PCB-schema/uScope/view2.jpeg

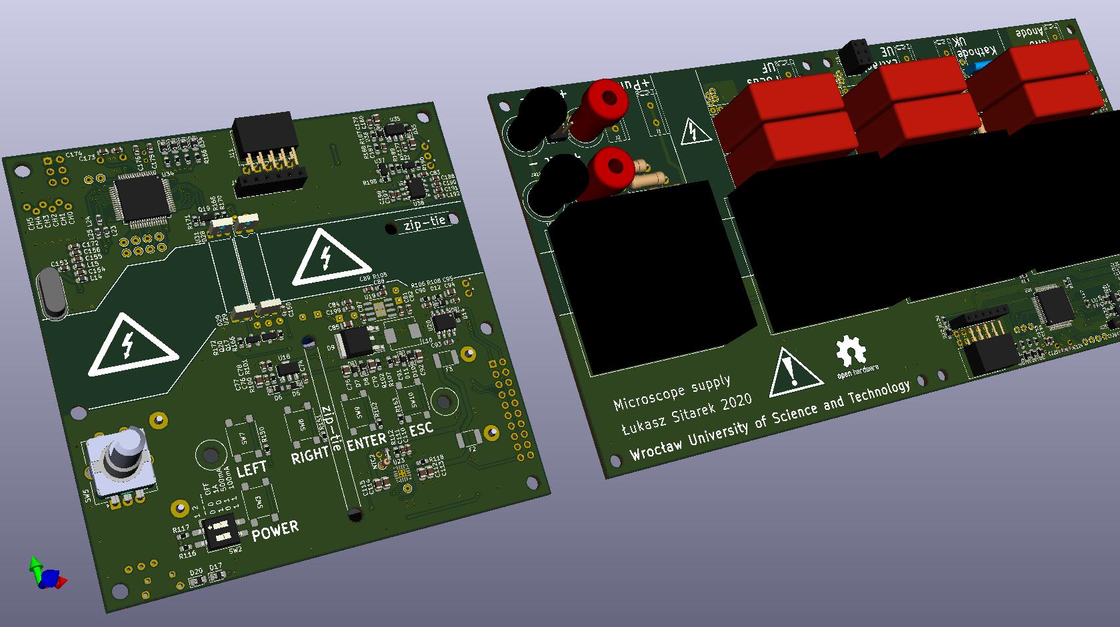
view2.jpeg
