PCB-schema/uScope/view1.jpeg

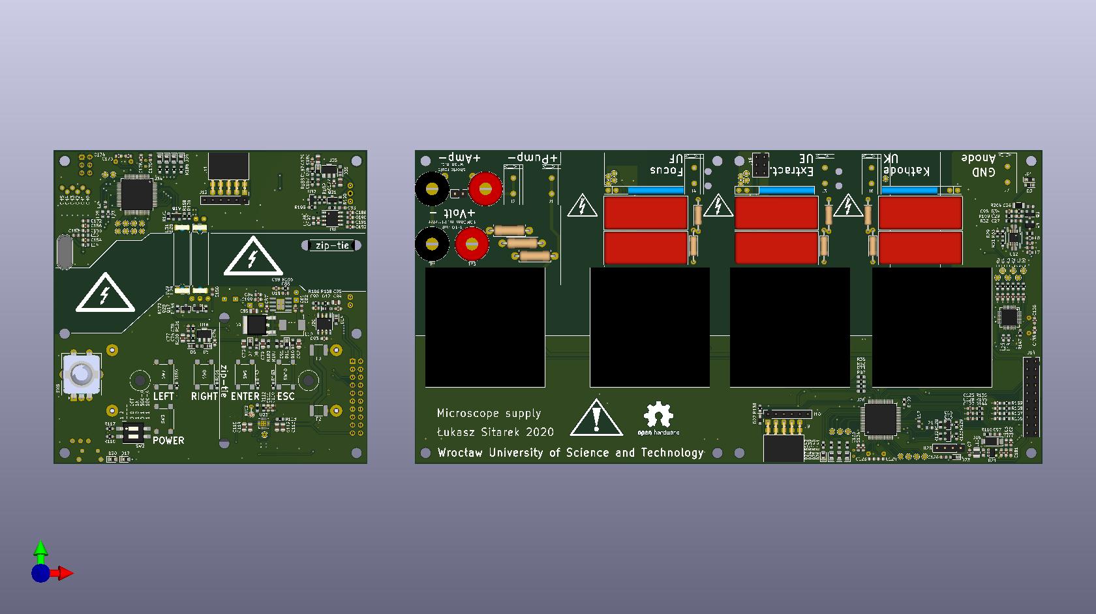
view1.jpeg
