PCB-schema/uScope/README.md

# uScope
Electron microscope
Project created with KiCAD v 5.0.2-bee76a0~70~ubuntu18.04.1, release build
