PCB-schema/uScope/view3.jpeg

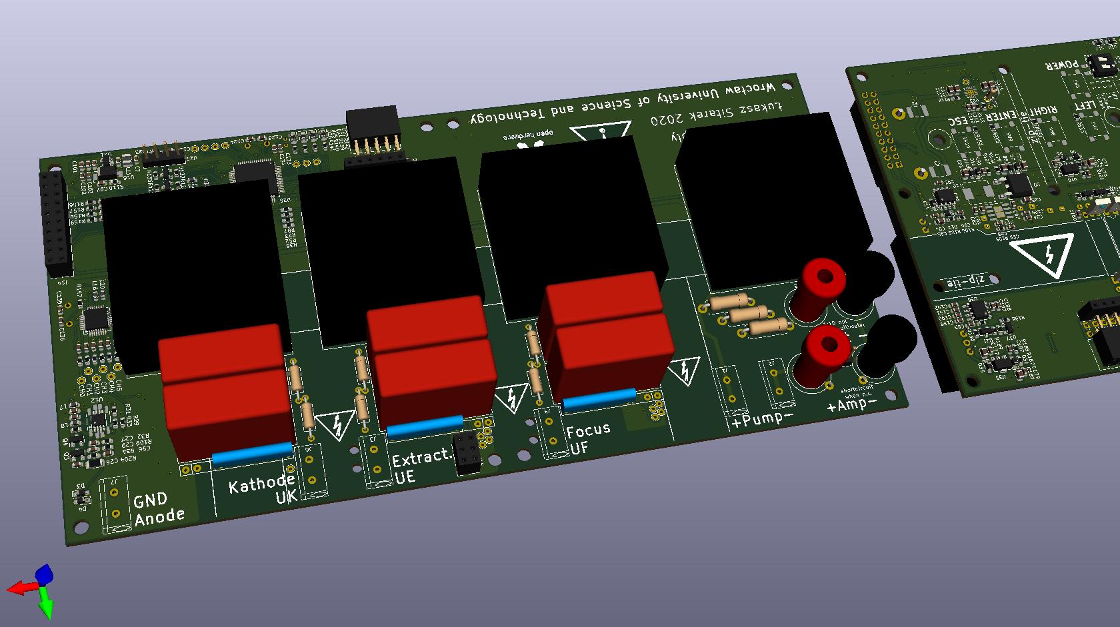
view3.jpeg
