PCB-schema/uScope/view4.jpeg

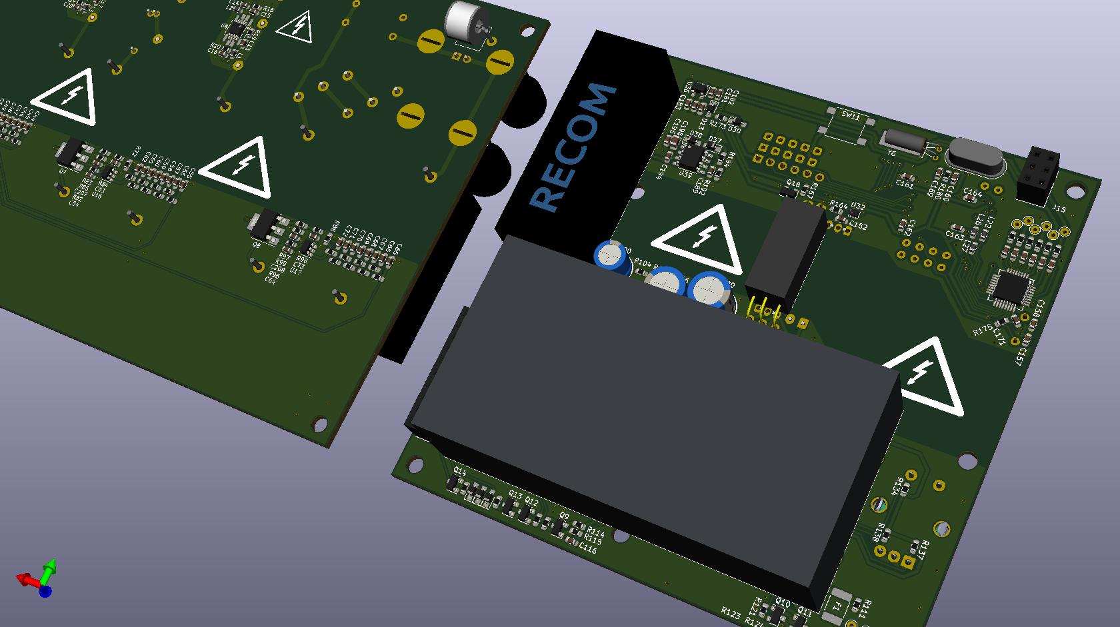
view4.jpeg
