PCB-schema/uScope/view5.jpeg

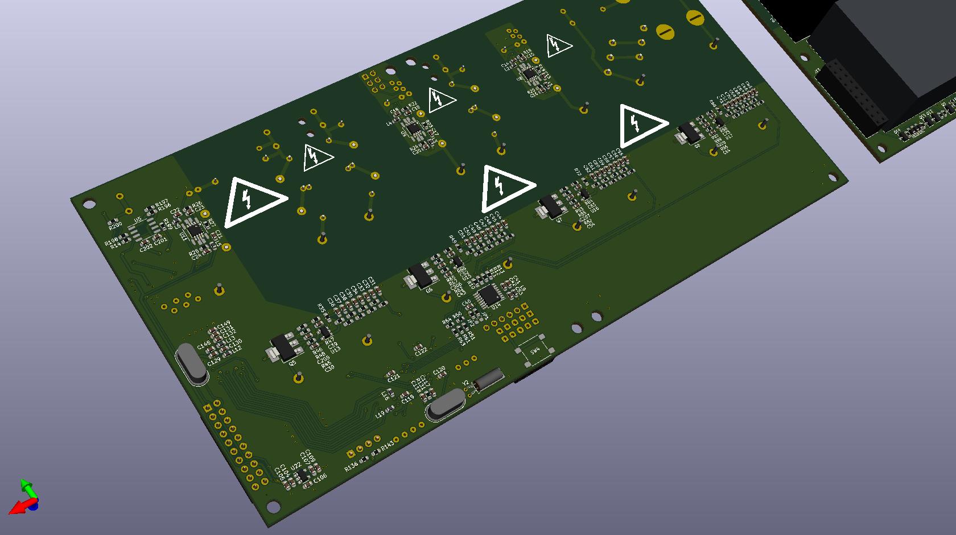
view5.jpeg
