PCB-schema/uScope/uScope.kicad_pcb

## KiCad design uScope.kicad_pcb (2021-03-14)

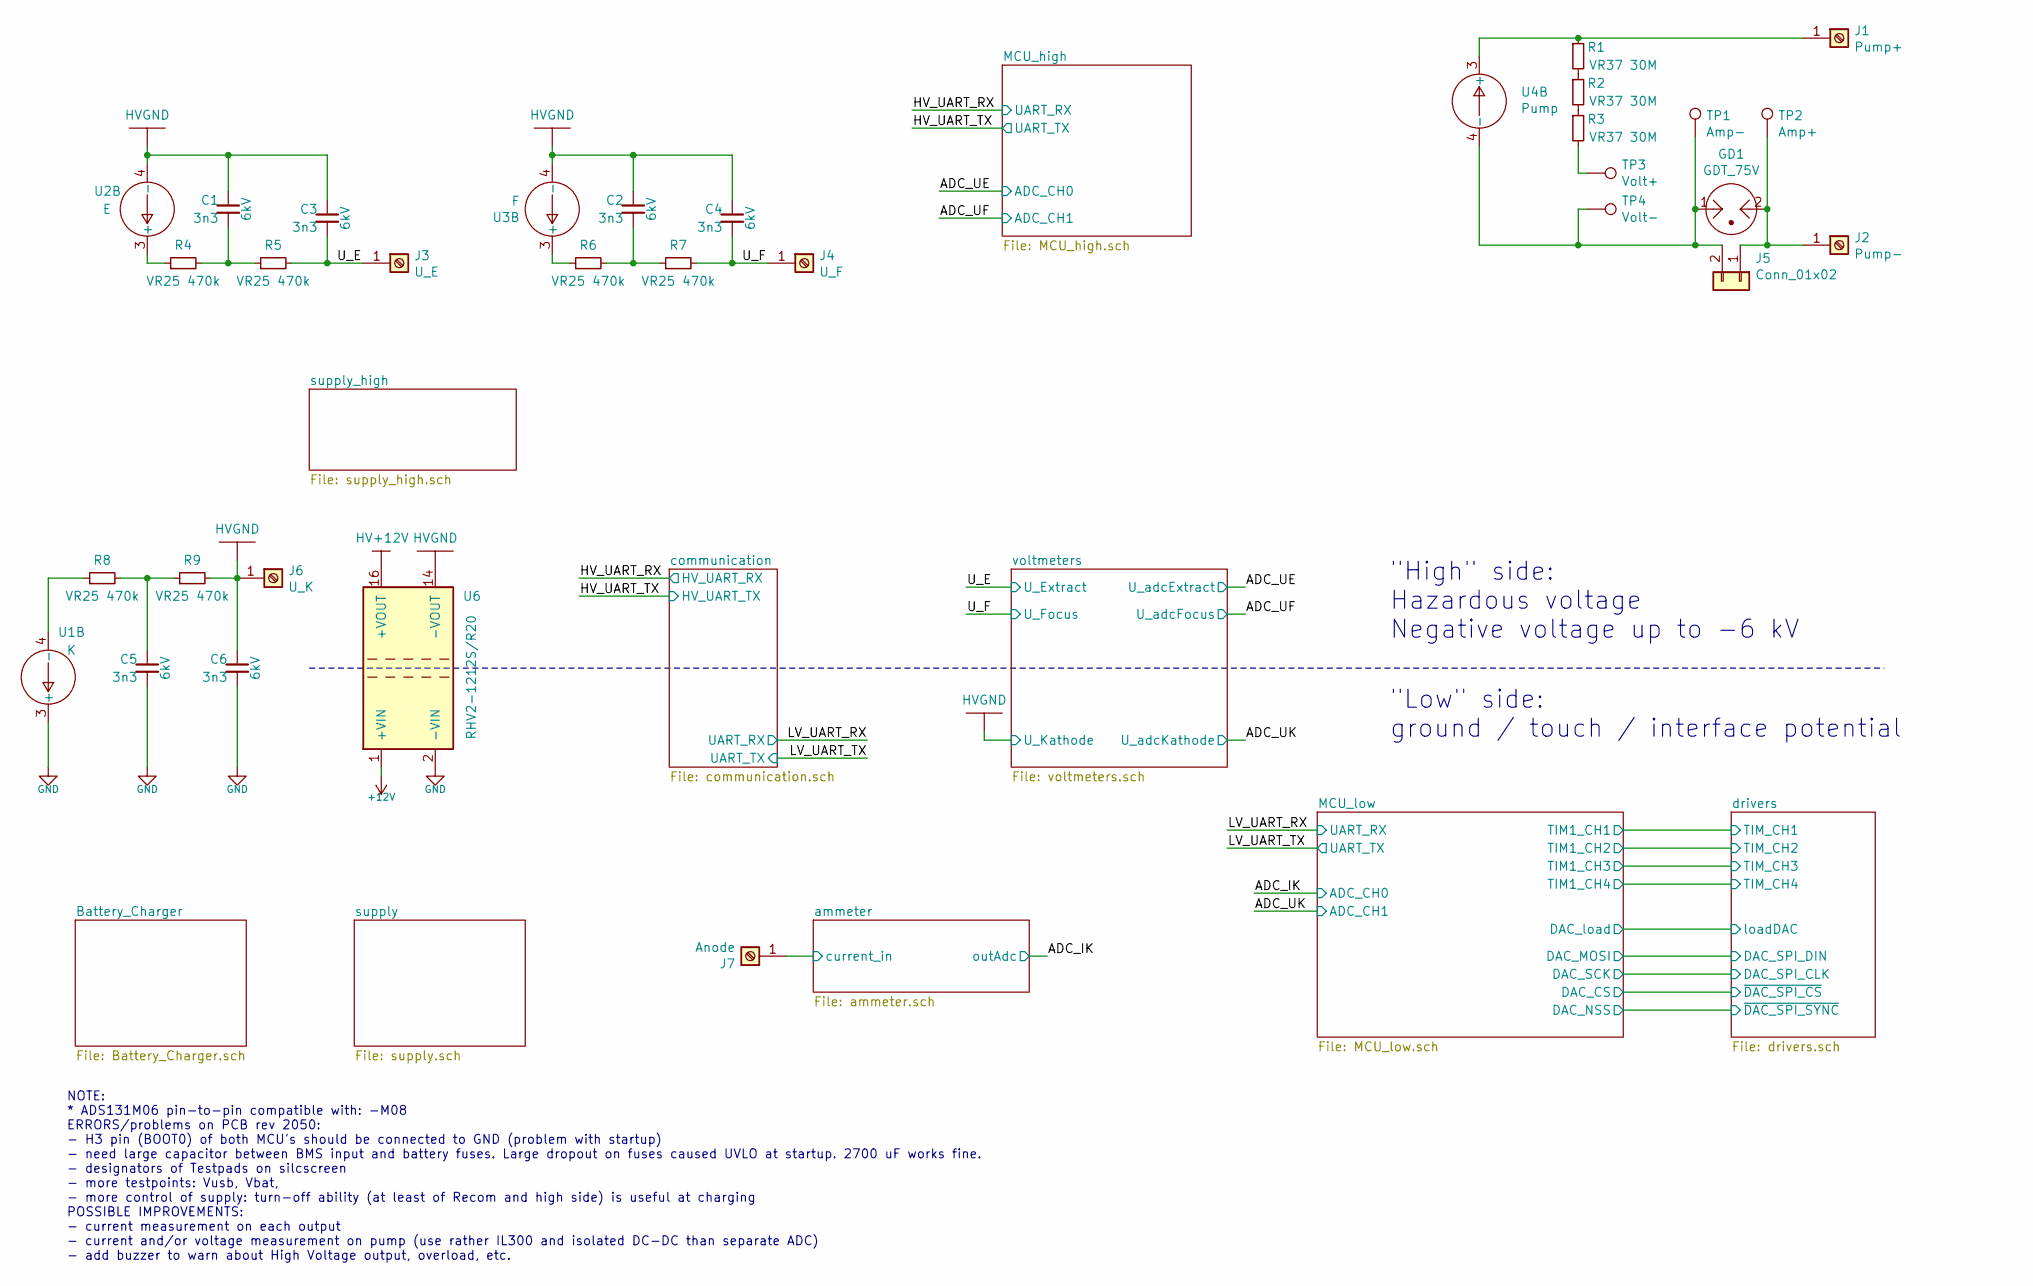
[picture p16: schematic uScope.sch, Schemat główny]

Parts:
C1, C2, C3, C4, C5, C6: 3n3; C_Rect_L26.5mm_W10.5mm_P22.50mm_MKS4; Voltage 6kV
GD1: GDT_75V; Arrester_Axial_L6mm_D6mm_P8.89mm_Horizontal
J1: Pump+; Terminal_Amp_HB0101
J2: Pump-; Terminal_Amp_HB0101
J3: U_E; Terminal_Amp_HB0101
J4: U_F; Terminal_Amp_HB0101
J5: Conn_01x02; PinHeader_1x02_P2.54mm_Vertical
J6: U_K; Terminal_Amp_HB0101
J7: Anode; Terminal_Amp_HB0101
R1, R2, R3: VR37 30M; R_Axial_DIN0411_L9.9mm_D3.6mm_P12.70mm_Horizontal
R4, R5, R6, R7, R8, R9: VR25 470k; R_Axial_DIN0207_L6.3mm_D2.5mm_P10.16mm_Horizontal
TP1: Amp-; Banana4mmSocket_black
TP2: Amp+; Banana4mmSocket_red
TP3: Volt+; Banana4mmSocket_red
TP4: Volt-; Banana4mmSocket_black
U1: K; DCDC_APD_P2_single
U2: E; DCDC_APD_P2_single
U3: F; DCDC_APD_P2_single
U4: Pump; DCDC_APD_P2_single
U6: RHV2-1212S/R20; SIP16_RECOM

Connections:
+12V: U6.1 (+VIN); also elsewhere on the board
/U_E: C3.2, J3.1, R5.2; also elsewhere on the board
/U_F: C4.2, J4.1, R7.2; also elsewhere on the board
/ammeter/current_in: J7.1; also elsewhere on the board
HV+12V: U6.16 (+VOUT); also elsewhere on the board
unnamed: C1.2, R4.2, R5.1
unnamed: C2.2, R6.2, R7.1
unnamed: C5.1, R8.2, R9.1
unnamed: GD1.1, J5.2, TP1.1, TP4.1, U4.4 (-)
unnamed: GD1.2, J2.1, J5.1, TP2.1
unnamed: J1.1, R1.1, U4.3 (+)
unnamed: R1.2, R2.1
unnamed: R2.2, R3.1
unnamed: R3.2, TP3.1
unnamed: R4.1, U2.3 (+)
unnamed: R6.1, U3.3 (+)
unnamed: R8.1, U1.4 (-)

Notes on the sheet:
NOTE: * ADS131M06 pin-to-pin compatible with: -M08 ERRORS/problems on PCB rev 2050: - H3 pin (BOOT0) of both MCU's should be connected to GND (problem with startup) - need large capacitor between BMS input and battery fuses. Large dropout on fuses caused UVLO at startup. 2700 uF works fine. - desig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
"High" side: Hazardous voltage Negative voltage up to -6 kV
"Low" side: ground / touch / interface potential

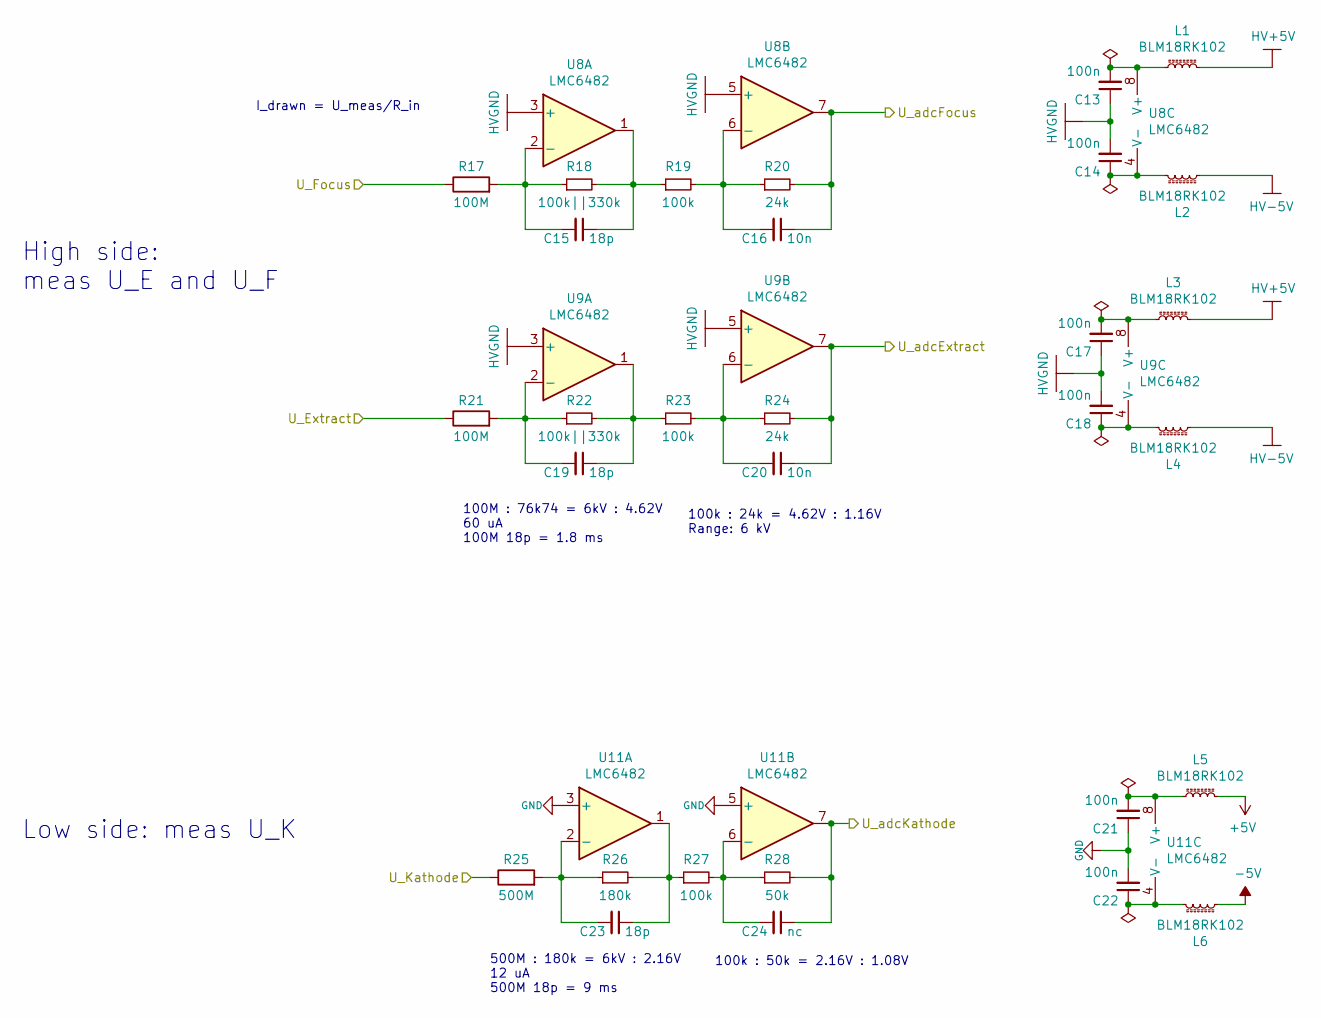
[picture p17: schematic voltmeters.sch, Woltomierze]

Parts:
C13, C14, C17, C18, C21, C22: 100n; C_0603_1608Metric
C15, C19, C23: 18p; C_0603_1608Metric
C16, C20: 10n; C_0603_1608Metric
C24: nc; C_0603_1608Metric
L1, L2, L3, L4, L5, L6: BLM18RK102; L_0603_1608Metric
R17, R21: 100M; MHR0317_0422_0424_0624SA
R18, R22: 100k||330k; R_0603_1608Metric
R19, R23, R27: 100k; R_0603_1608Metric
R20, R24: 24k; R_0603_1608Metric
R25: 500M; MHR0317_0422_0424_0624SA
R26: 180k; R_0603_1608Metric
R28: 50k; R_0603_1608Metric
U8, U9, U11: LMC6482; SO8-MSOP8_3x3mm_P0.65mm

Connections:
+5V: L5.2; also elsewhere on the board
-5V: L6.1; also elsewhere on the board
/ADC_UE: C20.1, R24.2, U9.7; also elsewhere on the board
/ADC_UF: C16.1, R20.2, U8.7; also elsewhere on the board
/ADC_UK: C24.1, R28.2, U11.7; also elsewhere on the board
/U_E: R21.1; also elsewhere on the board
/U_F: R17.1; also elsewhere on the board
HV+5V: L1.2, L3.2; also elsewhere on the board
HV-5V: L2.1, L4.1; also elsewhere on the board
unnamed: C13.2, L1.1, U8.8 (V+)
unnamed: C14.1, L2.2, U8.4 (V-)
unnamed: C15.1, R18.2, R19.1, U8.1
unnamed: C15.2, R17.2, R18.1, U8.2 (-)
unnamed: C16.2, R19.2, R20.1, U8.6 (-)
unnamed: C17.2, L3.1, U9.8 (V+)
unnamed: C18.1, L4.2, U9.4 (V-)
unnamed: C19.1, R22.2, R23.1, U9.1
unnamed: C19.2, R21.2, R22.1, U9.2 (-)
unnamed: C20.2, R23.2, R24.1, U9.6 (-)
unnamed: C21.2, L5.1, U11.8 (V+)
unnamed: C22.1, L6.2, U11.4 (V-)
unnamed: C23.1, R26.2, R27.1, U11.1
unnamed: C23.2, R25.2, R26.1, U11.2 (-)
unnamed: C24.2, R27.2, R28.1, U11.6 (-)

Notes on the sheet:
I_drawn = U_meas/R_in
Low side: meas U_K
High side: meas U_E and U_F
500M : 180k = 6kV : 2.16V 12 uA 500M 18p = 9 ms
100k : 50k = 2.16V : 1.08V
100M : 76k74 = 6kV : 4.62V 60 uA 100M 18p = 1.8 ms
100k : 24k = 4.62V : 1.16V Range: 6 kV

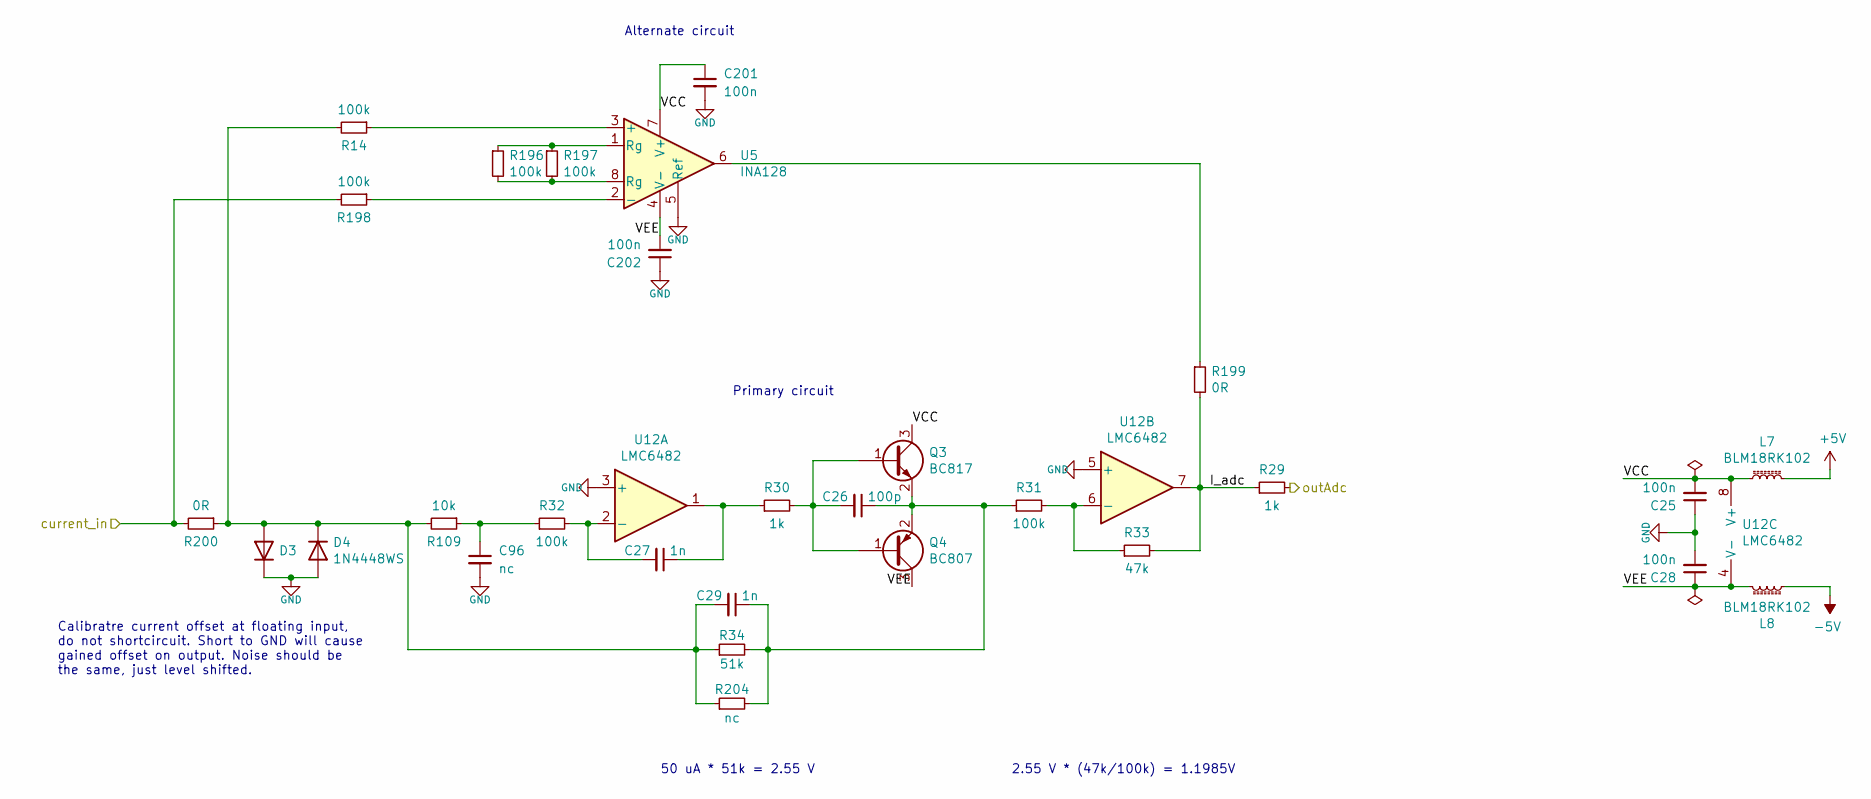
[picture p18: schematic ammeter.sch, Amperomierz]

Parts:
C25, C28, C201, C202: 100n; C_0603_1608Metric
C26: 100p; C_0603_1608Metric
C27: 1n; C_0603_1608Metric
C29: 1n; C_0603_1608Metric_Pad1.05x0.95mm_HandSolder
C96: nc; C_0603_1608Metric
D3, D4: 1N4448WS; D_SOD-323-523_HandSoldering
L7, L8: BLM18RK102; L_0603_1608Metric
Q3: BC817; SOT-23
Q4: BC807; SOT-23
R14, R31, R32, R198: 100k; R_0603_1608Metric
R29, R30: 1k; R_0603_1608Metric
R33: 47k; R_0603_1608Metric
R34: 51k; R_0603_1608Metric_Pad1.05x0.95mm_HandSolder
R109: 10k; R_0603_1608Metric
R196, R197: 100k; R_0603_1608Metric_Pad1.05x0.95mm_HandSolder
R199: 0R; R_0603_1608Metric
R200: 0R; R_0603_1608Metric_Pad1.05x0.95mm_HandSolder
R204: nc; R_1206_3216Metric
U5: INA128; SO-8_3.9x4.9mm_P1.27mm
U12: LMC6482; SO8-MSOP8_3x3mm_P0.65mm

Connections:
+5V: L7.2; also elsewhere on the board
-5V: L8.1; also elsewhere on the board
/ADC_IK: R29.2; also elsewhere on the board
/ammeter/I_adc: R29.1, R33.2, R199.2, U12.7
/ammeter/VCC: C25.2, C201.1, L7.1, Q3.3 (C), U5.7 (V+), U12.8 (V+)
/ammeter/VEE: C28.1, C202.2, L8.2, Q4.3 (C), U5.4 (V-), U12.4 (V-)
/ammeter/current_in: R198.2, R200.2; also elsewhere on the board
unnamed: C26.1, C29.1, Q3.2 (E), Q4.2 (E), R31.1, R34.2, R204.2
unnamed: C26.2, Q3.1 (B), Q4.1 (B), R30.2
unnamed: C27.1, R30.1, U12.1
unnamed: C27.2, R32.2, U12.2 (-)
unnamed: C29.2, D3.2 (A), D4.1 (K), R14.2, R34.1, R109.2, R200.1, R204.1
unnamed: C96.1, R32.1, R109.1
unnamed: R14.1, U5.3 (+)
unnamed: R31.2, R33.1, U12.6 (-)
unnamed: R196.1, R197.1, U5.1 (Rg)
unnamed: R196.2, R197.2, U5.8 (Rg)
unnamed: R198.1, U5.2 (-)
unnamed: R199.1, U5.6

Notes on the sheet:
Primary circuit
Alternate circuit
50 uA * 51k = 2.55 V
2.55 V * (47k/100k) = 1.1985V
Calibratre current offset at floating input, do not shortcircuit. Short to GND will cause gained offset on output. Noise should be the same, just level shifted.

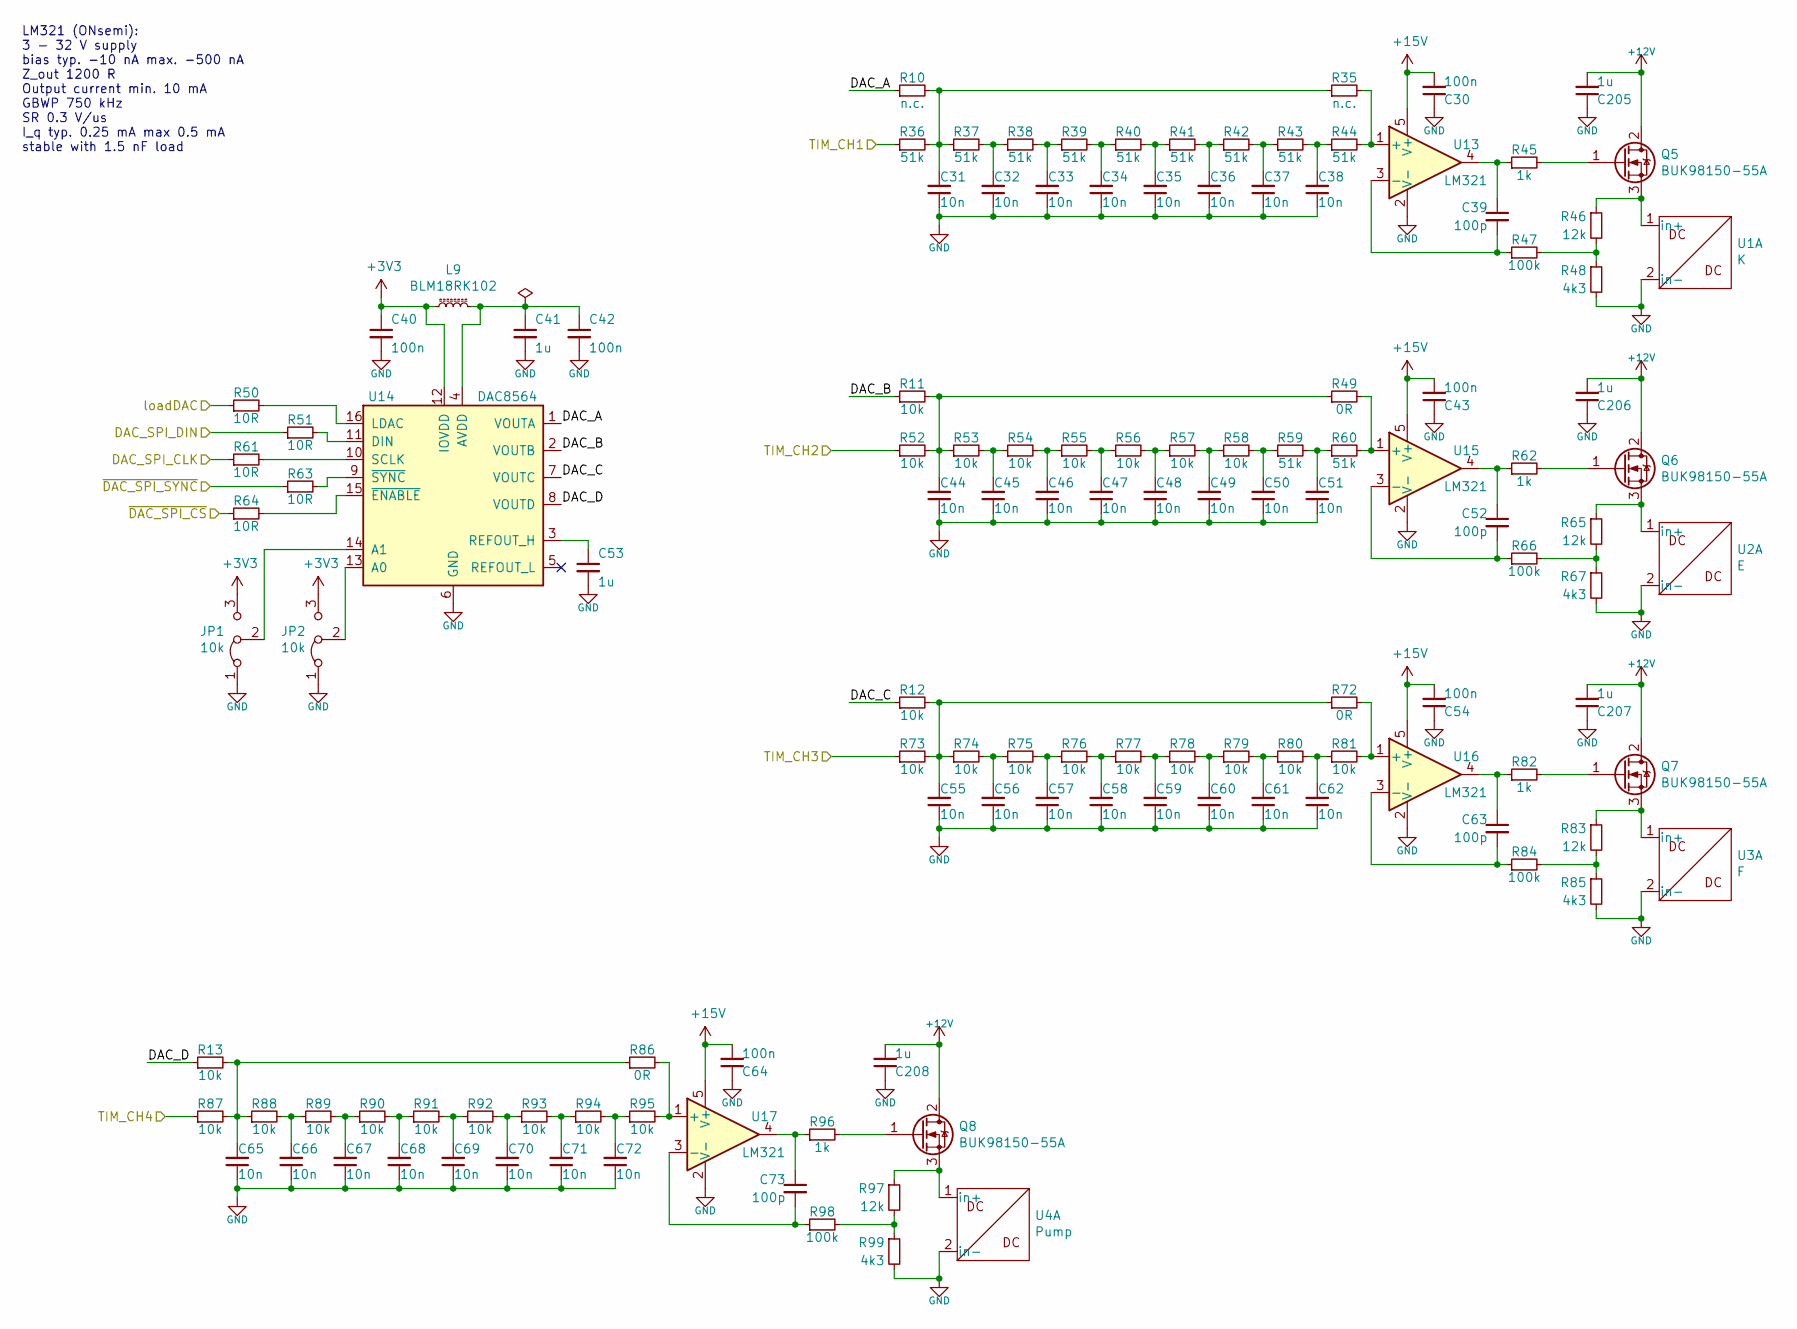
[picture p19: schematic drivers.sch, Sterowniki]

Parts:
C30, C40, C42, C43, C54, C64: 100n; C_0603_1608Metric
C31, C32, C33, C34, C35, C36, C37, C38, C44, C45, C46, C47, C48, C49, C50, C51, C55, C56, C57, C58, C59, C60, C61, C62, C65, C66, C67, C68, C69, C70, C71, C72: 10n; C_0603_1608Metric_Pad1.05x0.95mm_HandSolder
C39, C52, C63, C73: 100p; C_0603_1608Metric
C41, C53, C205, C206, C207, C208: 1u; C_0603_1608Metric
JP1, JP2: 10k; Jumper_3P_0603_1608Metric_open
L9: BLM18RK102; L_0603_1608Metric
Q5, Q6, Q7, Q8: BUK98150-55A; SOT-223-3_TabPin2
R10, R35: n.c.; R_0603_1608Metric_Pad1.05x0.95mm_HandSolder
R11, R12, R13, R52, R53, R54, R55, R56, R57, R58, R73, R74, R75, R76, R77, R78, R79, R80, R81, R87, R88, R89, R90, R91, R92, R93, R94, R95: 10k; R_0603_1608Metric_Pad1.05x0.95mm_HandSolder
R36, R37, R38, R39, R40, R41, R42, R43, R44, R59, R60: 51k; R_0603_1608Metric_Pad1.05x0.95mm_HandSolder
R45, R62, R82, R96: 1k; R_0603_1608Metric
R46, R65, R83, R97: 12k; R_0603_1608Metric_Pad1.05x0.95mm_HandSolder
R47, R66, R84, R98: 100k; R_0603_1608Metric
R48, R67, R85, R99: 4k3; R_0603_1608Metric_Pad1.05x0.95mm_HandSolder
R49, R72, R86: 0R; R_0603_1608Metric_Pad1.05x0.95mm_HandSolder
R50, R51, R61, R63, R64: 10R; R_0603_1608Metric
U1: K; DCDC_APD_P2_single
U2: E; DCDC_APD_P2_single
U3: F; DCDC_APD_P2_single
U4: Pump; DCDC_APD_P2_single
U13, U15, U16, U17: LM321; SOT-23-5
U14: DAC8564; TSSOP-16_4.4x5mm_P0.65mm

Connections:
+3V3: C40.1, JP1.3 (B), JP2.3 (B), L9.1, U14.12 (IOVDD); also elsewhere on the board
+12V: C205.2, C206.2, C207.2, C208.2, Q5.2 (D), Q6.2 (D), Q7.2 (D), Q8.2 (D); also elsewhere on the board
+15V: C30.2, C43.2, C54.2, C64.2, U13.5 (V+), U15.5 (V+), U16.5 (V+), U17.5 (V+); also elsewhere on the board
/MCU_low/DAC_CS: R64.1; also elsewhere on the board
/MCU_low/DAC_MOSI: R51.1; also elsewhere on the board
/MCU_low/DAC_NSS: R63.1; also elsewhere on the board
/MCU_low/DAC_SCK: R61.1; also elsewhere on the board
/MCU_low/DAC_load: R50.1; also elsewhere on the board
/MCU_low/TIM1_CH1: R36.1; also elsewhere on the board
/MCU_low/TIM1_CH2: R52.1; also elsewhere on the board
/MCU_low/TIM1_CH3: R73.1; also elsewhere on the board
/MCU_low/TIM1_CH4: R87.1; also elsewhere on the board
/drivers/DAC_A: R10.1, U14.1 (VOUTA)
/drivers/DAC_B: R11.1, U14.2 (VOUTB)
/drivers/DAC_C: R12.1, U14.7 (VOUTC)
/drivers/DAC_D: R13.1, U14.8 (VOUTD)
unnamed: C31.2, R10.2, R35.1, R36.2, R37.1
unnamed: C32.2, R37.2, R38.1
unnamed: C33.2, R38.2, R39.1
unnamed: C34.2, R39.2, R40.1
unnamed: C35.2, R40.2, R41.1
unnamed: C36.2, R41.2, R42.1
unnamed: C37.2, R42.2, R43.1
unnamed: C38.2, R43.2, R44.1
unnamed: C39.1, R45.1, U13.4
unnamed: C39.2, R47.1, U13.3 (-)
unnamed: C41.1, C42.1, L9.2, U14.4 (AVDD)
unnamed: C44.2, R11.2, R49.1, R52.2, R53.1
unnamed: C45.2, R53.2, R54.1
unnamed: C46.2, R54.2, R55.1
unnamed: C47.2, R55.2, R56.1
unnamed: C48.2, R56.2, R57.1
unnamed: C49.2, R57.2, R58.1
unnamed: C50.2, R58.2, R59.1
unnamed: C51.2, R59.2, R60.1
unnamed: C52.1, R62.1, U15.4
unnamed: C52.2, R66.1, U15.3 (-)
unnamed: C53.1, U14.3 (REFOUT_H)
unnamed: C55.2, R12.2, R72.1, R73.2, R74.1
unnamed: C56.2, R74.2, R75.1
unnamed: C57.2, R75.2, R76.1
unnamed: C58.2, R76.2, R77.1
unnamed: C59.2, R77.2, R78.1
unnamed: C60.2, R78.2, R79.1
unnamed: C61.2, R79.2, R80.1
unnamed: C62.2, R80.2, R81.1
unnamed: C63.1, R82.1, U16.4
unnamed: C63.2, R84.1, U16.3 (-)
unnamed: C65.2, R13.2, R86.1, R87.2, R88.1
unnamed: C66.2, R88.2, R89.1
unnamed: C67.2, R89.2, R90.1
unnamed: C68.2, R90.2, R91.1
unnamed: C69.2, R91.2, R92.1
unnamed: C70.2, R92.2, R93.1
unnamed: C71.2, R93.2, R94.1
unnamed: C72.2, R94.2, R95.1
unnamed: C73.1, R96.1, U17.4
unnamed: C73.2, R98.1, U17.3 (-)
unnamed: JP1.2 (C), U14.14 (A1)
unnamed: JP2.2 (C), U14.13 (A0)
unnamed: Q5.1 (G), R45.2
unnamed: Q5.3 (S), R46.1, U1.1 (in+)
unnamed: Q6.1 (G), R62.2
unnamed: Q6.3 (S), R65.1, U2.1 (in+)
unnamed: Q7.1 (G), R82.2
unnamed: Q7.3 (S), R83.1, U3.1 (in+)
unnamed: Q8.1 (G), R96.2
unnamed: Q8.3 (S), R97.1, U4.1 (in+)
unnamed: R35.2, R44.2, U13.1 (+)
unnamed: R46.2, R47.2, R48.1
unnamed: R49.2, R60.2, U15.1 (+)
unnamed: R50.2, U14.16 (LDAC)
unnamed: R51.2, U14.11 (DIN)
unnamed: R61.2, U14.10 (SCLK)
unnamed: R63.2, U14.9 (~SYNC)
unnamed: R64.2, U14.15 (~ENABLE)
unnamed: R65.2, R66.2, R67.1
unnamed: R72.2, R81.2, U16.1 (+)
unnamed: R83.2, R84.2, R85.1
unnamed: R86.2, R95.2, U17.1 (+)
unnamed: R97.2, R98.2, R99.1

Notes on the sheet:
LM321 (ONsemi): 3 - 32 V supply bias typ. -10 nA max. -500 nA Z_out 1200 R Output current min. 10 mA GBWP 750 kHz SR 0.3 V/us I_q typ. 0.25 mA max 0.5 mA stable with 1.5 nF load

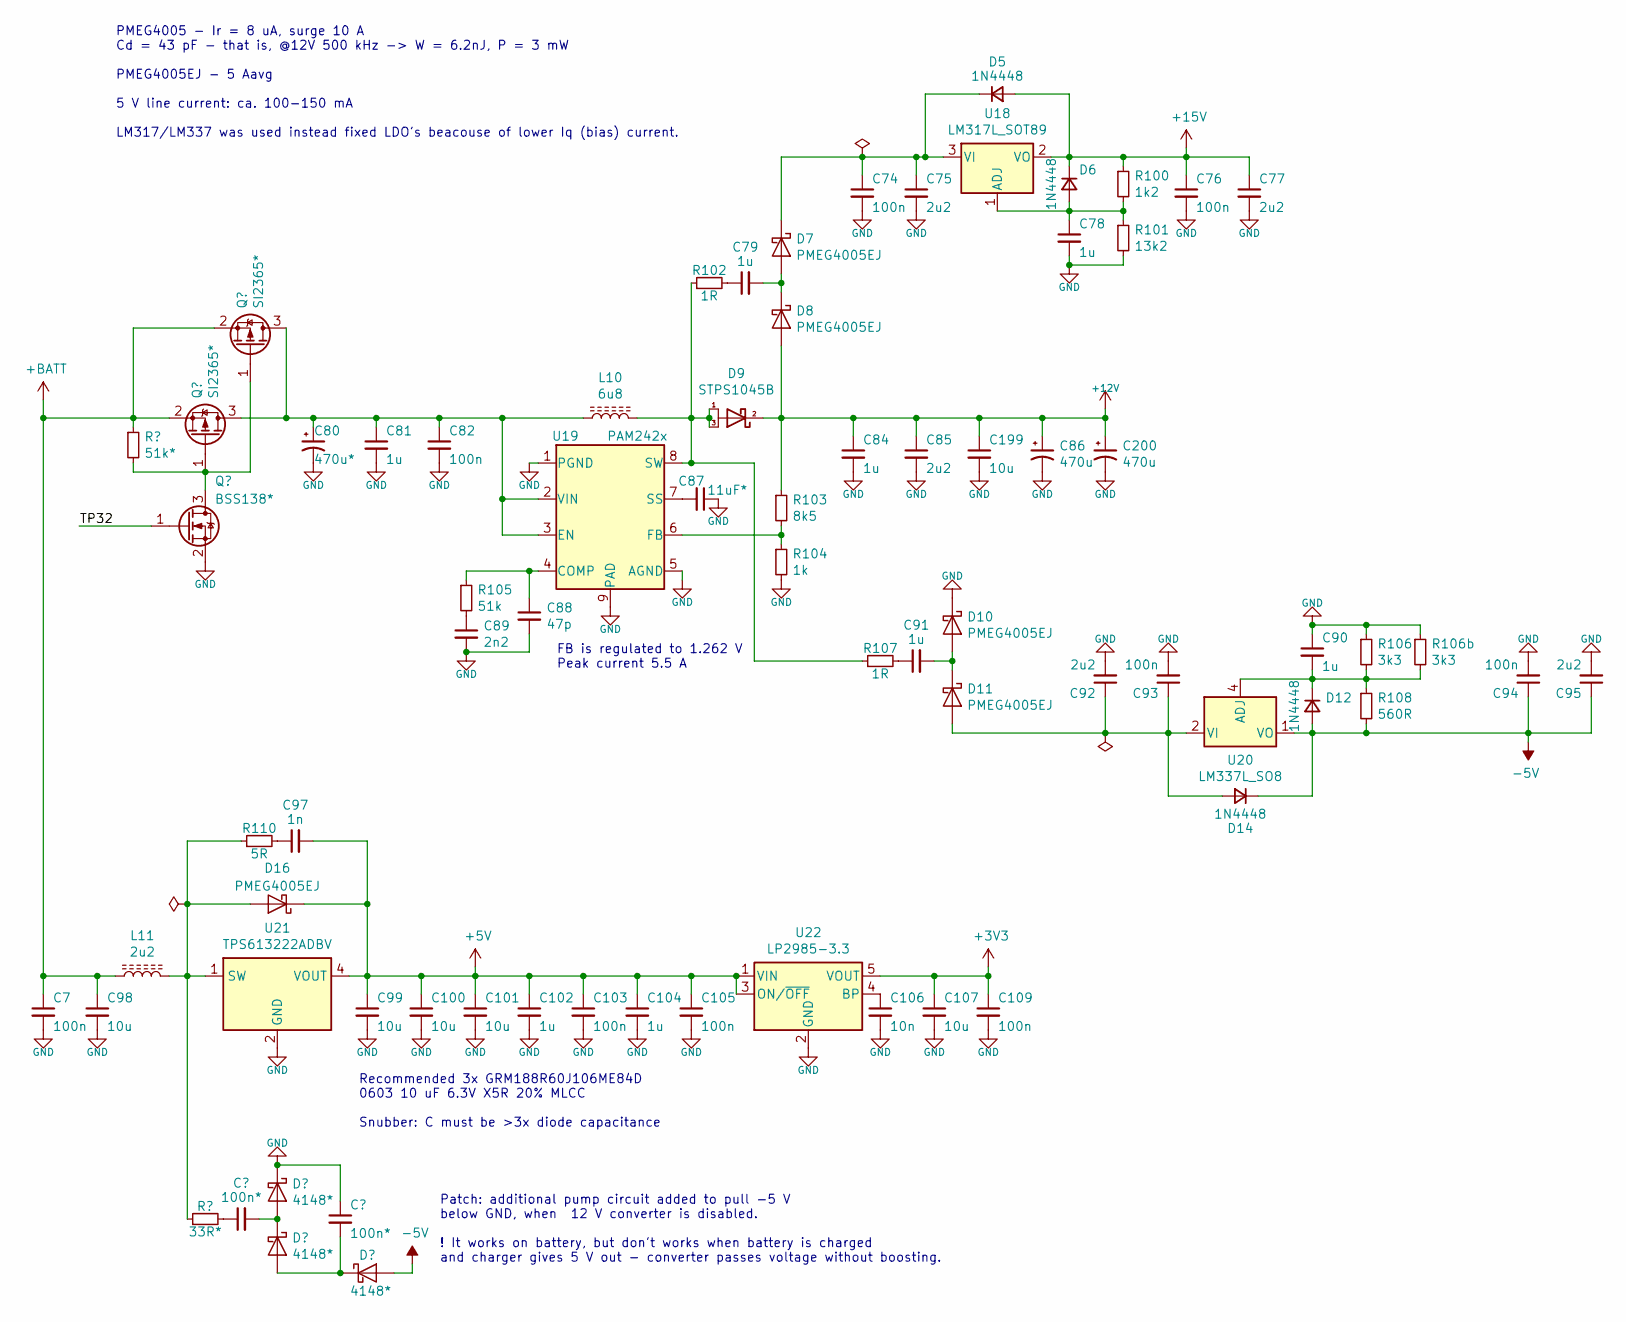
[picture p20: schematic supply.sch, Zasilanie - anoda]

Parts:
C7, C74, C76, C82, C93, C94, C103, C105, C109: 100n; C_0603_1608Metric
C75, C77, C85, C95: 2u2; C_0805_2012Metric
C78, C81, C84, C90, C91, C102, C104: 1u; C_0603_1608Metric
C79: 1u; C_0805_2012Metric_Pad1.15x1.40mm_HandSolder
C80: 470u*; CP_Radial_D6.3mm_P2.50mm
C86, C200: 470u; CP_Radial_D8.0mm_P3.50mm
C87: 11uF*; C_0603_1608Metric
C88: 47p; C_0603_1608Metric
C89: 2n2; C_0603_1608Metric
C92: 2u2; C_0805_2012Metric_Pad1.15x1.40mm_HandSolder
C97: 1n; C_0603_1608Metric
C98, C99, C100, C101, C107, C199: 10u; C_0603_1608Metric_Pad1.05x0.95mm_HandSolder
C106: 10n; C_0603_1608Metric
D5, D6, D12, D14: 1N4448; D_SOD-323-523_HandSoldering
D7, D8, D10, D11: PMEG4005EJ; D_SOD-323-523_HandSoldering
D9: STPS1045B; TO-252-2
D16: PMEG4005EJ; D_SOD-323-523-SMA_Universal_Handsoldering
L10: 6u8; L_Abracon_ASPI-0630LR
L11: 2u2; L_1008_2520Metric
R100: 1k2; R_0603_1608Metric
R101: 13k2; R_0603_1608Metric
R102, R107: 1R; R_0603_1608Metric_Pad1.05x0.95mm_HandSolder
R103: 8k5; R_0603_1608Metric
R104: 1k; R_0603_1608Metric
R105: 51k; R_0603_1608Metric
R106: 3k3; R_0603_1608Metric
R106b: 3k3
R108: 560R; R_0603_1608Metric
R110: 5R; R_0603_1608Metric_Pad1.05x0.95mm_HandSolder
U18: LM317L_SOT89; SOT-89-3
U19: PAM242x; SOIC-8-1EP_3.9x4.9mm_P1.27mm_EP2.41x3.3mm_ThermalVias
U20: LM337L_SO8; SOIC-8_3.9x4.9mm_P1.27mm
U21: TPS613222ADBV; SOT-23-5
U22: LP2985-3.3; SOT-23-5

Connections:
+3V3: C107.1, C109.1, U22.5 (VOUT); also elsewhere on the board
+5V: C97.2, C99.1, C100.1, C101.1, C102.1, C103.1, C104.1, C105.1, D16.1 (K), U21.4 (VOUT), U22.1 (VIN), U22.3 (ON/~OFF~); also elsewhere on the board
+12V: C84.1, C85.1, C86.1, C199.1, C200.1, D8.2 (A), D9.2 (K), R103.1; also elsewhere on the board
+15V: C76.1, C77.1, D5.2 (A), D6.1 (K), R100.1, U18.2 (VO); also elsewhere on the board
-5V: C94.1, C95.1, D12.2 (A), D14.1 (K), R108.2, U20.1 (VO); also elsewhere on the board
unnamed: C74.1, C75.1, D5.1 (K), D7.1 (K), U18.3 (VI)
unnamed: C78.1, D6.2 (A), R100.2, R101.1, U18.1 (ADJ)
unnamed: C79.1, R102.2
unnamed: C79.2, D7.2 (A), D8.1 (K)
unnamed: C87.2, U19.7 (SS)
unnamed: C88.1, R105.1, U19.4 (COMP)
unnamed: C89.1, R105.2
unnamed: C90.2, D12.1 (K), R106.2, R106b.2, R108.1, U20.4 (ADJ)
unnamed: C91.1, R107.2
unnamed: C91.2, D10.2 (A), D11.1 (K)
unnamed: C92.1, C93.1, D11.2 (A), D14.2 (A), U20.2 (VI), U20.3 (VI), U20.6 (VI), U20.7 (VI)
unnamed: C97.1, R110.2
unnamed: C106.1, U22.4 (BP)
unnamed: D9.1 (A), D9.3 (A), L10.2, R102.1, R107.1, U19.8 (SW)
unnamed: D16.2 (A), L11.2, R110.1, U21.1 (SW)
unnamed: R103.2, R104.1, U19.6 (FB)

Notes on the sheet:
FB is regulated to 1.262 V Peak current 5.5 A
PMEG4005 - Ir = 8 uA, surge 10 A Cd = 43 pF - that is, @12V 500 kHz -> W = 6.2nJ, P = 3 mW PMEG4005EJ - 5 Aavg 5 V line current: ca. 100-150 mA LM317/LM337 was used instead fixed LDO's beacouse of lower Iq (bias) current.
Recommended 3x GRM188R60J106ME84D 0603 10 uF 6.3V X5R 20% MLCC Snubber: C must be >3x diode capacitance
Patch: additional pump circuit added to pull -5 V below GND, when 12 V converter is disabled. ! It works on battery, but don't works when battery is charged and charger gives 5 V out - converter passes voltage without boosting.

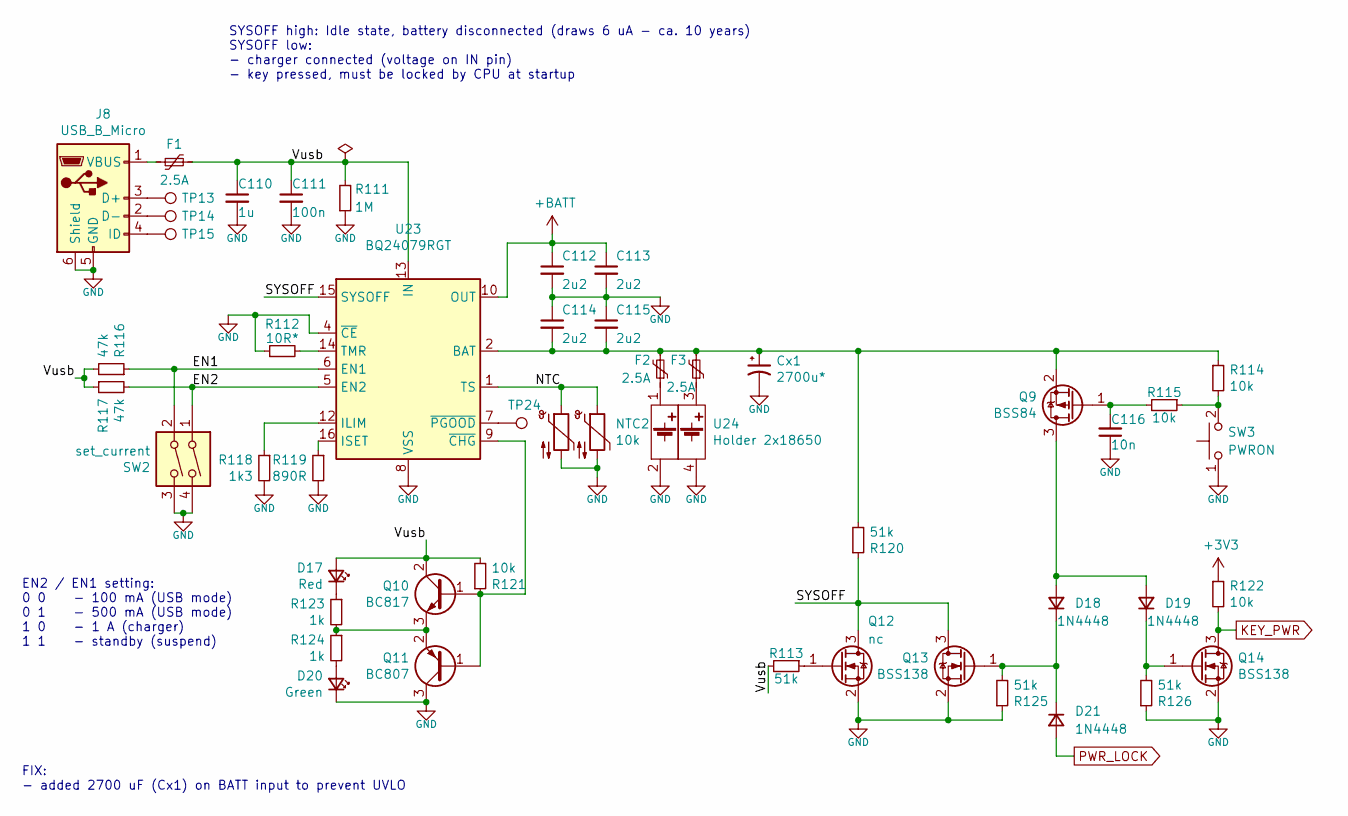
[picture p21: schematic Battery_Charger.sch, Zasilanie - bateria]

Parts:
C110: 1u; C_0603_1608Metric
C111: 100n; C_0603_1608Metric
C112, C113, C114, C115: 2u2; C_0805_2012Metric
C116: 10n; C_0603_1608Metric
Cx1: 2700u*
D17: Red; D_0805_2012Metric_Pad1.15x1.40mm_HandSolder
D18, D19, D21: 1N4448; D_SOD-323-523_HandSoldering
D20: Green; D_0805_2012Metric_Pad1.15x1.40mm_HandSolder
F1, F2, F3: 2.5A; Fuse_1812_4532Metric_Pad1.30x3.40mm_HandSolder
J8: USB_B_Micro; USB_Micro-B_Amphenol_10118194_Horizontal
NTC1: 10k; R_1206_3216Metric_Pad1.42x1.75mm_HandSolder
NTC2: 10k; R_Axial_DIN0204_L3.6mm_D1.6mm_P2.54mm_Vertical
Q9: BSS84; SOT-23
Q10: BC817; SOT-23
Q11: BC807; SOT-23
Q12: nc; SOT-23
Q13, Q14: BSS138; SOT-23
R111: 1M; R_0603_1608Metric
R112: 10R*; R_0603_1608Metric
R113, R120, R125, R126: 51k; R_0603_1608Metric
R114, R115, R121, R122: 10k; R_0603_1608Metric
R116, R117: 47k; R_0603_1608Metric
R118: 1k3; R_0603_1608Metric_Pad1.05x0.95mm_HandSolder
R119: 890R; R_0603_1608Metric_Pad1.05x0.95mm_HandSolder
R123, R124: 1k; R_0603_1608Metric
SW2: set_current; SW_DIP_SPSTx02_Slide_6.7x6.64mm_W8.61mm_P2.54mm_LowProfile
SW3: PWRON; SW_Push_1P1T_NO_6x6mm_H9.5mm
TP13, TP14, TP15, TP24: TestPoint; TestPoint_THTPad_D1.5mm_Drill0.7mm
U23: BQ24079RGT; VQFN-16-1EP_3x3mm_P0.5mm_EP1.6x1.6mm
U24: Holder 2x18650; BatteryHolder_Eagle-12BHC186P

Connections:
+3V3: R122.1; also elsewhere on the board
/Battery_Charger/EN1: R116.1, SW2.2, U23.6 (EN1)
/Battery_Charger/EN2: R117.2, SW2.1, U23.5 (EN2)
/Battery_Charger/NTC: NTC1.1, NTC2.1, U23.1 (TS)
/Battery_Charger/SYSOFF: Q12.3 (D), Q13.3 (D), R120.1, U23.15 (SYSOFF)
/Battery_Charger/Vusb: C110.1, C111.1, D17.2 (A), F1.2, Q10.2 (C), R111.2, R113.2, R116.2, R117.1, R121.2, U23.13 (IN)
KEY_PWR: Q14.3 (D), R122.2; also elsewhere on the board
unnamed: C114.2, C115.2, Cx1.1, F2.2, F3.2, Q9.2 (S), R114.1, R120.2, U23.2 (BAT), U23.3 (BAT)
unnamed: C116.2, Q9.1 (G), R115.2
unnamed: D17.1 (K), R123.1
unnamed: D18.1 (K), D21.1 (K), Q13.1 (G), R125.2
unnamed: D18.2 (A), D19.2 (A), Q9.3 (D)
unnamed: D19.1 (K), Q14.1 (G), R126.2
unnamed: D20.2 (A), R124.2
unnamed: F1.1, J8.1 (VBUS)
unnamed: F2.1, U24.1 (1+)
unnamed: F3.1, U24.3 (2+)
unnamed: J8.2 (D-), TP14.1
unnamed: J8.3 (D+), TP13.1
unnamed: J8.4 (ID), TP15.1
unnamed: Q10.1 (B), Q11.1 (B), R121.1, U23.9 (~CHG)
unnamed: Q10.3 (E), Q11.2 (E), R123.2, R124.1
unnamed: Q12.1 (G), R113.1
unnamed: R112.2, U23.14 (TMR)
unnamed: R114.2, R115.1, SW3.2
unnamed: R118.1, U23.12 (ILIM)
unnamed: R119.1, U23.16 (ISET)
unnamed: TP24.1, U23.7 (~PGOOD)
PWR_LOCK: D21.2 (A); also elsewhere on the board

Notes on the sheet:
SYSOFF high: Idle state, battery disconnected (draws 6 uA - ca. 10 years) SYSOFF low: - charger connected (voltage on IN pin) - key pressed, must be locked by CPU at startup
EN2 / EN1 setting: 0 0 - 100 mA (USB mode) 0 1 - 500 mA (USB mode) 1 0 - 1 A (charger) 1 1 - standby (suspend)
FIX: - added 2700 uF (Cx1) on BATT input to prevent UVLO
