PCB-schema/uScope/uScope.kicad_pcb

## KiCad design uScope.kicad_pcb (continued)

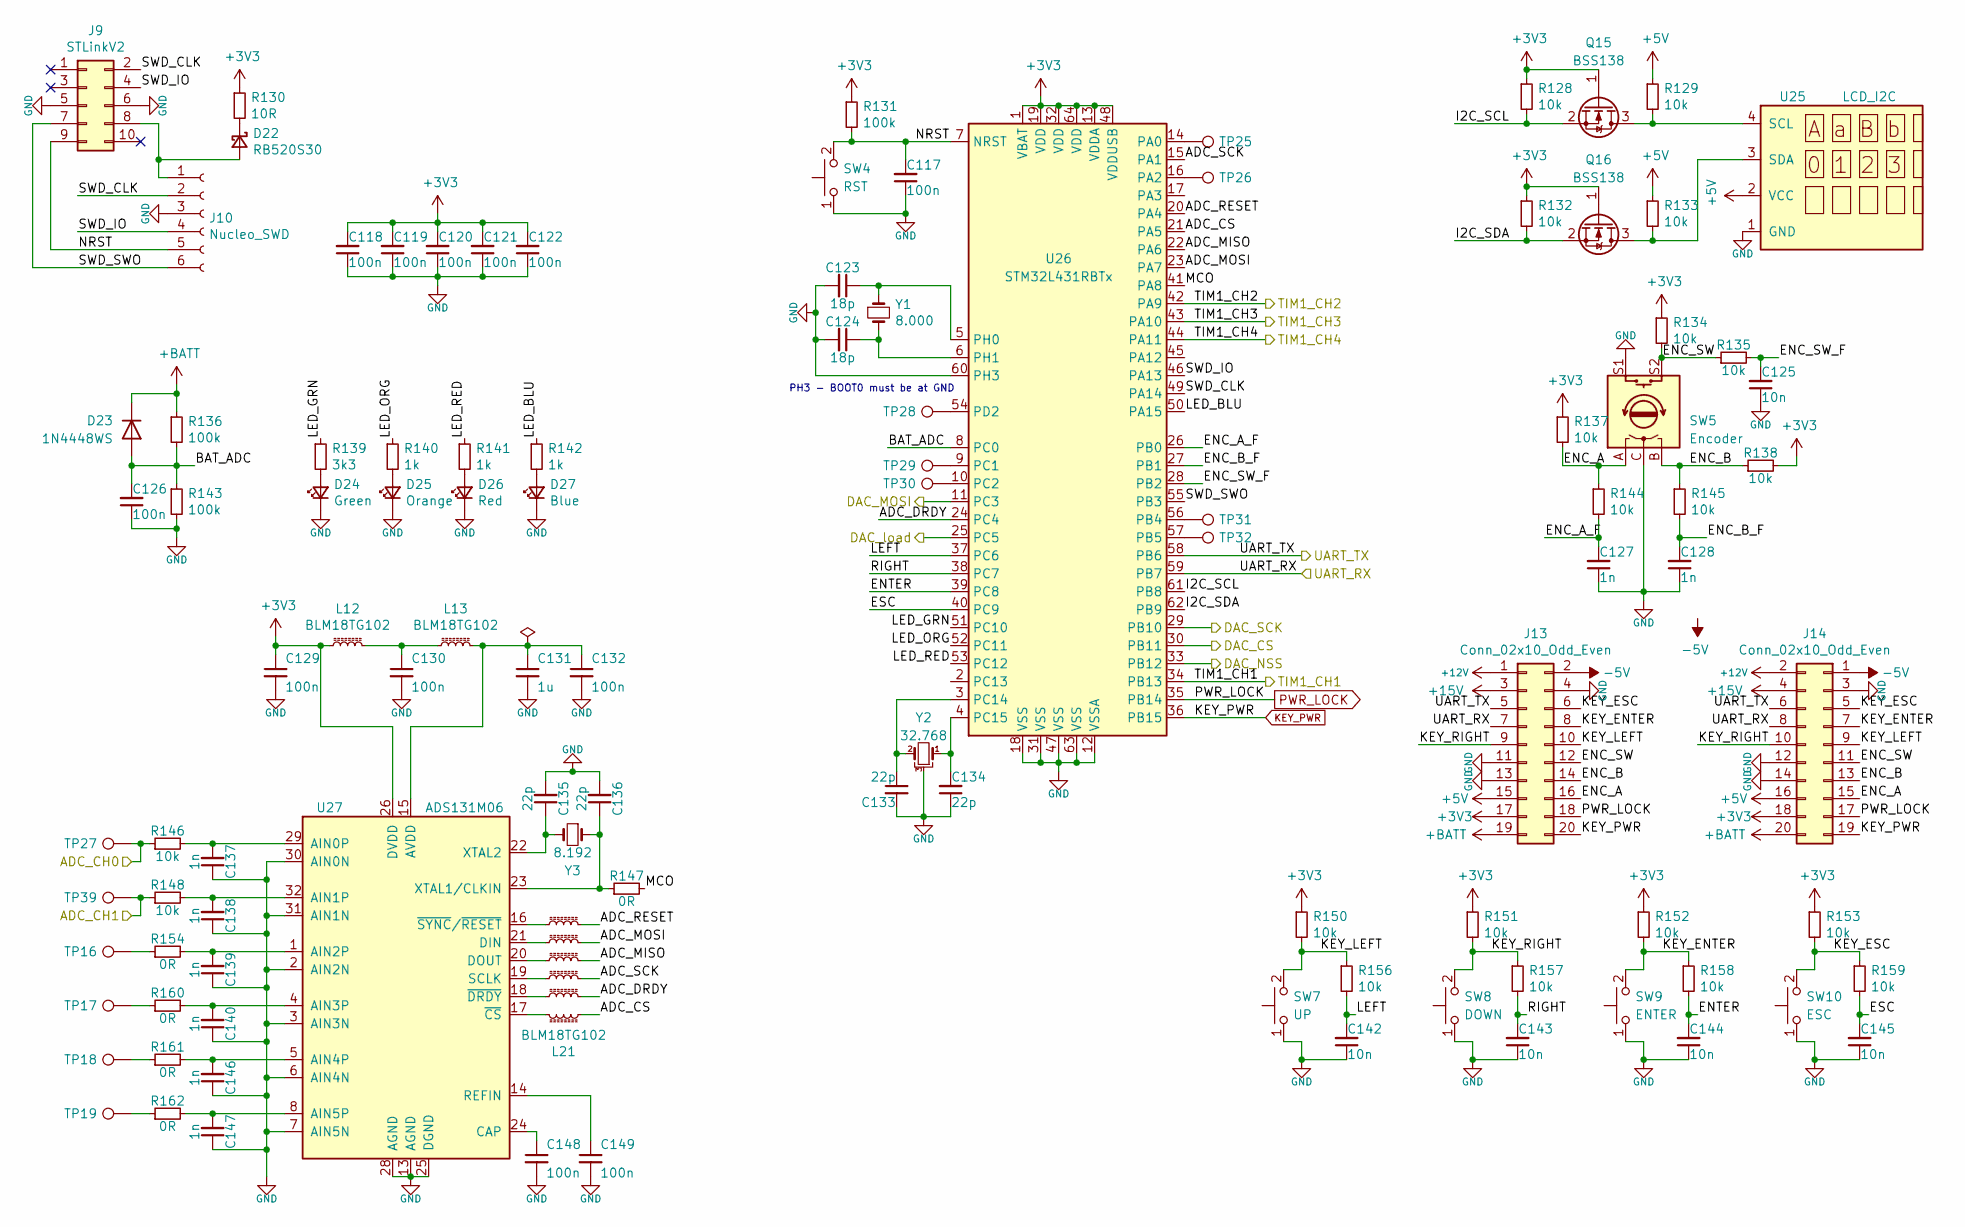
[picture p22: schematic MCU_low.sch, Procesor - anoda]

Parts:
C117, C118, C119, C120, C121, C122, C126, C129, C130, C132, C148, C149: 100n; C_0603_1608Metric
C123, C124: 18p; C_0603_1608Metric
C125, C142, C143, C144, C145: 10n; C_0603_1608Metric
C127, C128, C137, C138, C139, C140, C146, C147: 1n; C_0603_1608Metric
C131: 1u; C_0603_1608Metric
C133, C134, C135, C136: 22p; C_0603_1608Metric
D22: RB520S30; D_SOD-323-523_HandSoldering
D23: 1N4448WS; D_SOD-323-523_HandSoldering
D24: Green; D_0805_2012Metric_Pad1.15x1.40mm_HandSolder
D25: Orange; D_0805_2012Metric_Pad1.15x1.40mm_HandSolder
D26: Red; D_0805_2012Metric_Pad1.15x1.40mm_HandSolder
D27: Blue; D_0805_2012Metric_Pad1.15x1.40mm_HandSolder
J9: STLinkV2; ST-LinkV2_FakeStm8Stm32_vertical
J10: Nucleo_SWD; PinSocket_1x06_P2.54mm_Vertical
J13, J14: Conn_02x10_Odd_Even; PinSocket_2x10_P2.54mm_Vertical
L12, L13, L16, L17, L18, L19, L20, L21: BLM18TG102; L_0603_1608Metric
Q15, Q16: BSS138; SOT-23
R128, R129, R132, R133, R134, R135, R137, R138, R144, R145, R146, R148, R150, R151, R152, R153, R156, R157, R158, R159: 10k; R_0603_1608Metric
R130: 10R; R_0603_1608Metric
R131, R136, R143: 100k; R_0603_1608Metric
R139: 3k3; R_0603_1608Metric
R140, R141, R142: 1k; R_0603_1608Metric
R147, R154, R160, R161, R162: 0R; R_0603_1608Metric
SW4: RST; SW_Push_1P1T_NO_6x6mm_H9.5mm
SW5: Encoder; Encoder_12.4x13.4_pitch2.5mm_wSw
SW7: UP; SW_Push_1P1T_NO_6x6mm_H9.5mm
SW8: DOWN; SW_Push_1P1T_NO_6x6mm_H9.5mm
SW9: ENTER; SW_Push_1P1T_NO_6x6mm_H9.5mm
SW10: ESC; SW_Push_1P1T_NO_6x6mm_H9.5mm
TP16, TP17, TP18, TP19, TP25, TP26, TP27, TP28, TP29, TP30, TP31, TP32, TP39: TestPoint; TestPoint_THTPad_D1.5mm_Drill0.7mm
U25: LCD_I2C; PinHeader_1x04_P2.54mm_Vertical
U26: STM32L431RBTx; LQFP-64_10x10mm_P0.5mm
U27: ADS131M06; TQFP-32_5x5mm_P0.5mm_edges
Y1: 8.000; Crystal_HC49-4H_Vertical
Y2: 32.768; Crystal_C38-LF_D3.0mm_L8.0mm_Horizontal_1EP_style1
Y3: 8.192; Crystal_HC49-4H_Vertical

Connections:
+3V3: C118.2, C119.2, C120.2, C121.2, C122.2, C129.1, J13.17, J14.18, L12.1, Q15.1 (G), Q16.1 (G), R128.1, R130.1, R131.1, R132.1, R134.1, R137.1, R138.2, R150.1, R151.1, R152.1, R153.1, U26.1 (VBAT), U26.13 (VDDA), U26.19 (VDD), U26.32 (VDD), U26.48 (VDDUSB), U26.64 (VDD), U27.26 (DVDD); also elsewhere on the board
+5V: J13.15, J14.16, R129.1, R133.1, U25.2 (VCC); also elsewhere on the board
+12V: J13.1, J14.2; also elsewhere on the board
+15V: J13.3, J14.4; also elsewhere on the board
-5V: J13.2, J14.1; also elsewhere on the board
/ADC_IK: R146.1, TP27.1; also elsewhere on the board
/ADC_UK: R148.1, TP39.1; also elsewhere on the board
/LV_UART_RX: J13.7, J14.8, U26.59 (PB7); also elsewhere on the board
/LV_UART_TX: J13.5, J14.6, U26.58 (PB6); also elsewhere on the board
/MCU_low/ADC_CS: L21.1, U26.21 (PA5)
/MCU_low/ADC_DRDY: L20.2, U26.24 (PC4)
/MCU_low/ADC_MISO: L18.2, U26.22 (PA6)
/MCU_low/ADC_MOSI: L17.2, U26.23 (PA7)
/MCU_low/ADC_RESET: L16.2, U26.20 (PA4)
/MCU_low/ADC_SCK: L19.2, U26.15 (PA1)
/MCU_low/BAT_ADC: C126.2, D23.2 (A), R136.2, R143.1, U26.8 (PC0)
/MCU_low/DAC_CS: U26.30 (PB11); also elsewhere on the board
/MCU_low/DAC_MOSI: U26.11 (PC3); also elsewhere on the board
/MCU_low/DAC_NSS: U26.33 (PB12); also elsewhere on the board
/MCU_low/DAC_SCK: U26.29 (PB10); also elsewhere on the board
/MCU_low/DAC_load: U26.25 (PC5); also elsewhere on the board
/MCU_low/ENC_A: J13.16, J14.15, R137.2, R144.1, SW5.A
/MCU_low/ENC_A_F: C127.2, R144.2, U26.26 (PB0)
/MCU_low/ENC_B: J13.14, J14.13, R138.1, R145.1, SW5.B
/MCU_low/ENC_B_F: C128.2, R145.2, U26.27 (PB1)
/MCU_low/ENC_SW: J13.12, J14.11, R134.2, R135.1, SW5.S2
/MCU_low/ENC_SW_F: C125.2, R135.2, U26.28 (PB2)
/MCU_low/ENTER: C144.2, R158.2, U26.39 (PC8)
/MCU_low/ESC: C145.2, R159.2, U26.40 (PC9)
/MCU_low/I2C_SCL: Q15.2 (S), R128.2, U26.61 (PB8)
/MCU_low/I2C_SDA: Q16.2 (S), R132.2, U26.62 (PB9)
/MCU_low/KEY_ENTER: J13.8, J14.7, R152.2, R158.1, SW9.2
/MCU_low/KEY_ESC: J13.6, J14.5, R153.2, R159.1, SW10.2
/MCU_low/KEY_LEFT: J13.10, J14.9, R150.2, R156.1, SW7.2
/MCU_low/KEY_RIGHT: J13.9, J14.10, R151.2, R157.1, SW8.2
/MCU_low/LED_BLU: R142.1, U26.50 (PA15)
/MCU_low/LED_GRN: R139.1, U26.51 (PC10)
/MCU_low/LED_ORG: R140.1, U26.52 (PC11)
/MCU_low/LED_RED: R141.1, U26.53 (PC12)
/MCU_low/LEFT: C142.2, R156.2, U26.37 (PC6)
/MCU_low/MCO: R147.2, U26.41 (PA8)
/MCU_low/NRST: C117.2, J9.9, J10.5, R131.2, SW4.2, U26.7 (NRST)
/MCU_low/RIGHT: C143.2, R157.2, U26.38 (PC7)
/MCU_low/SWD_CLK: J9.2, J10.2, U26.49 (PA14)
/MCU_low/SWD_IO: J9.4, J10.4, U26.46 (PA13)
/MCU_low/SWD_SWO: J9.7, J10.6, U26.55 (PB3)
/MCU_low/TIM1_CH1: U26.34 (PB13); also elsewhere on the board
/MCU_low/TIM1_CH2: U26.42 (PA9); also elsewhere on the board
/MCU_low/TIM1_CH3: U26.43 (PA10); also elsewhere on the board
/MCU_low/TIM1_CH4: U26.44 (PA11); also elsewhere on the board
KEY_PWR: J13.20, J14.19, U26.36 (PB15); also elsewhere on the board
unnamed: C123.1, U26.5 (PH0), Y1.1
unnamed: C124.1, U26.6 (PH1), Y1.2
unnamed: C130.1, L12.2, L13.1
unnamed: C131.1, C132.1, L13.2, U27.15 (AVDD)
unnamed: C133.1, U26.3 (PC14), Y2.2
unnamed: C134.2, U26.4 (PC15), Y2.1
unnamed: C135.1, U27.22 (XTAL2), Y3.2
unnamed: C136.1, R147.1, U27.23 (XTAL1/CLKIN), Y3.1
unnamed: C137.2, R146.2, U27.29 (AIN0P)
unnamed: C138.2, R148.2, U27.32 (AIN1P)
unnamed: C139.2, R154.2, U27.1 (AIN2P)
unnamed: C140.2, R160.2, U27.4 (AIN3P)
unnamed: C146.2, R161.2, U27.5 (AIN4P)
unnamed: C147.2, R162.2, U27.8 (AIN5P)
unnamed: C148.1, U27.24 (CAP)
unnamed: C149.1, U27.14 (REFIN)
unnamed: D22.1 (K), R130.2
unnamed: D22.2 (A), J9.8, J10.1
unnamed: D24.2 (A), R139.2
unnamed: D25.2 (A), R140.2
unnamed: D26.2 (A), R141.2
unnamed: D27.2 (A), R142.2
unnamed: L16.1, U27.16 (~SYNC~/~RESET)
unnamed: L17.1, U27.21 (DIN)
unnamed: L18.1, U27.20 (DOUT)
unnamed: L19.1, U27.19 (SCLK)
unnamed: L20.1, U27.18 (~DRDY)
unnamed: L21.2, U27.17 (~CS)
unnamed: Q15.3 (D), R129.2, U25.4 (SCL)
unnamed: Q16.3 (D), R133.2, U25.3 (SDA)
unnamed: R154.1, TP16.1
unnamed: R160.1, TP17.1
unnamed: R161.1, TP18.1
unnamed: R162.1, TP19.1
unnamed: TP25.1, U26.14 (PA0)
unnamed: TP26.1, U26.16 (PA2)
unnamed: TP28.1, U26.54 (PD2)
unnamed: TP29.1, U26.9 (PC1)
unnamed: TP30.1, U26.10 (PC2)
unnamed: TP31.1, U26.56 (PB4)
unnamed: TP32.1, U26.57 (PB5)
PWR_LOCK: J13.18, J14.17, U26.35 (PB14); also elsewhere on the board

Notes on the sheet:
PH3 - BOOT0 must be at GND

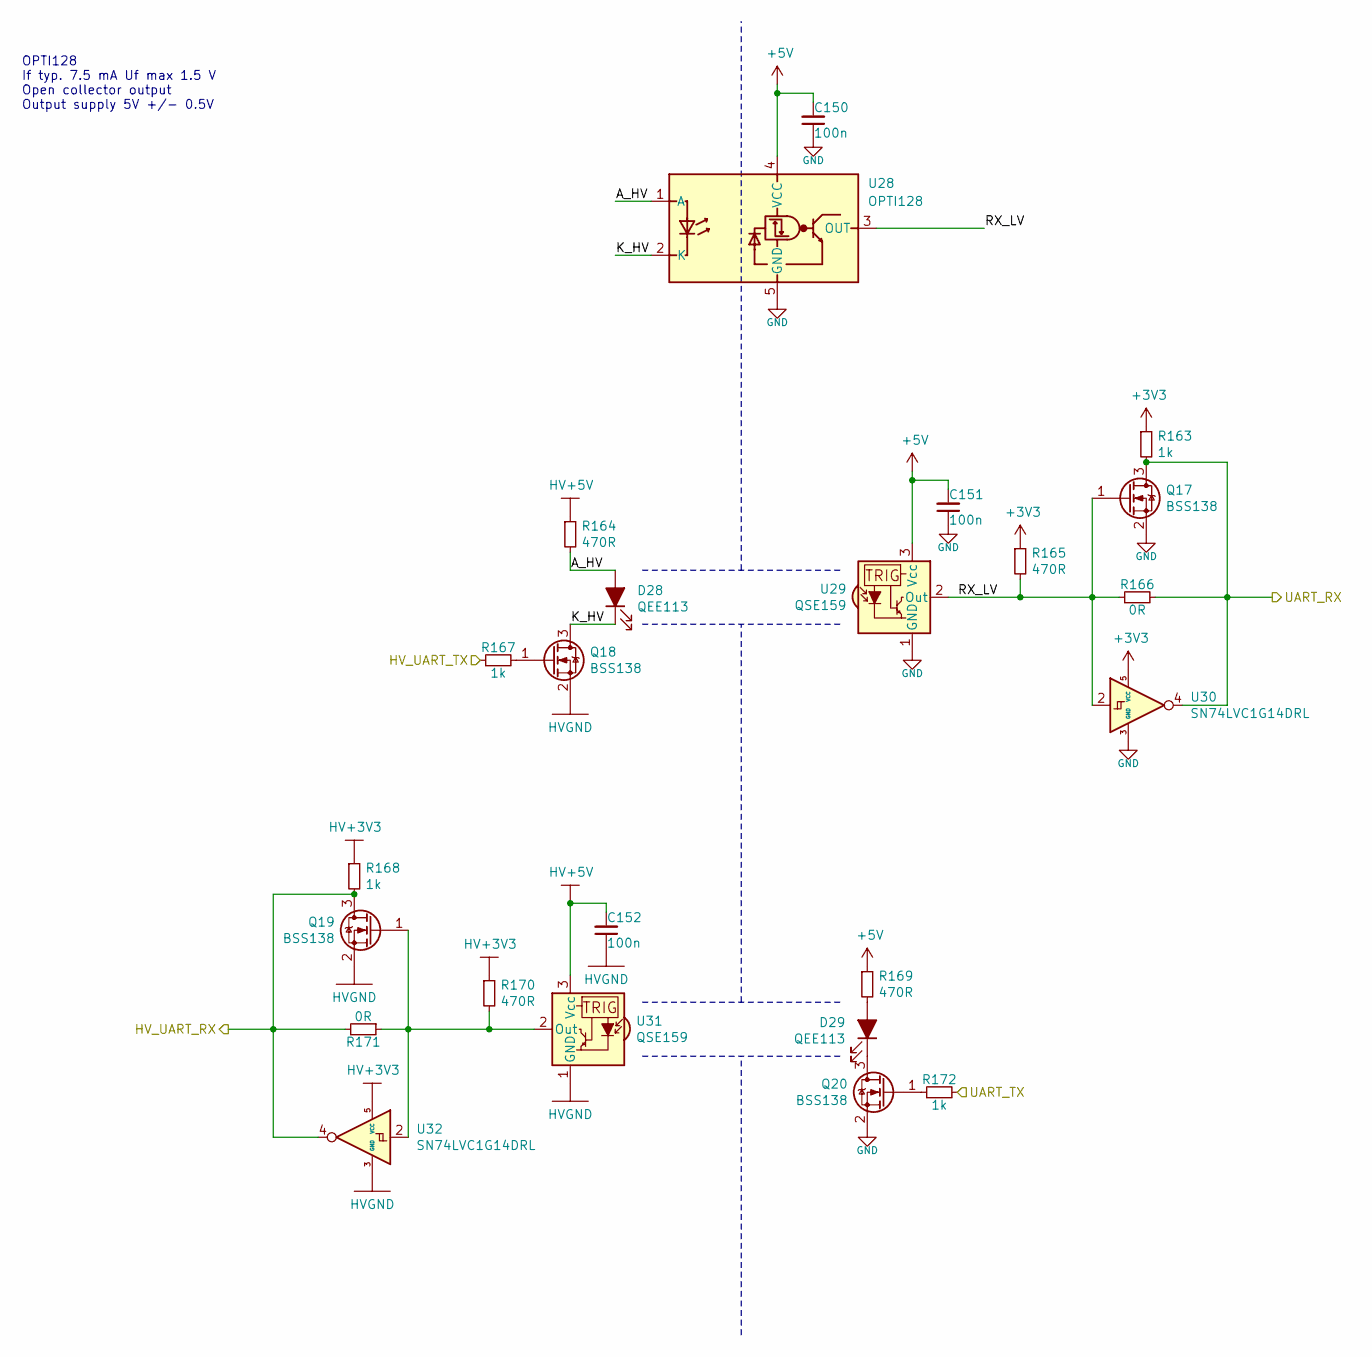
[picture p23: schematic communication.sch, Komunikacja]

Parts:
C150, C151, C152: 100n; C_0603_1608Metric
D28, D29: QEE113; ONsemi_QEE113
Q17, Q18, Q19, Q20: BSS138; SOT-23
R163, R167, R168, R172: 1k; R_0603_1608Metric
R164, R165, R169, R170: 470R; R_0603_1608Metric
R166, R171: 0R; R_0603_1608Metric
U28: OPTI128; OPTI12x
U29, U31: QSE159; ONSemi_QSE15x
U30, U32: SN74LVC1G14DRL; SOT-553

Connections:
+3V3: R163.1, R165.1, U30.5 (VCC); also elsewhere on the board
+5V: C150.2, C151.2, R169.1, U28.4 (VCC), U29.3 (Vcc); also elsewhere on the board
/HV_UART_RX: Q19.3 (D), R168.2, R171.2, U32.4; also elsewhere on the board
/HV_UART_TX: R167.1; also elsewhere on the board
/LV_UART_RX: Q17.3 (D), R163.2, R166.2, U30.4; also elsewhere on the board
/LV_UART_TX: R172.2; also elsewhere on the board
/communication/A_HV: D28.2 (A), R164.2, U28.1 (A)
/communication/K_HV: D28.1 (K), Q18.3 (D), U28.2 (K)
/communication/RX_LV: Q17.1 (G), R165.2, R166.1, U28.3 (OUT), U29.2 (Out), U30.2
HV+3V3: R168.1, R170.1, U32.5 (VCC); also elsewhere on the board
HV+5V: C152.2, R164.1, U31.3 (Vcc); also elsewhere on the board
unnamed: D29.1 (K), Q20.3 (D)
unnamed: D29.2 (A), R169.2
unnamed: Q18.1 (G), R167.2
unnamed: Q19.1 (G), R170.2, R171.1, U31.2 (Out), U32.2
unnamed: Q20.1 (G), R172.1

Notes on the sheet:
OPTI128 If typ. 7.5 mA Uf max 1.5 V Open collector output Output supply 5V +/- 0.5V

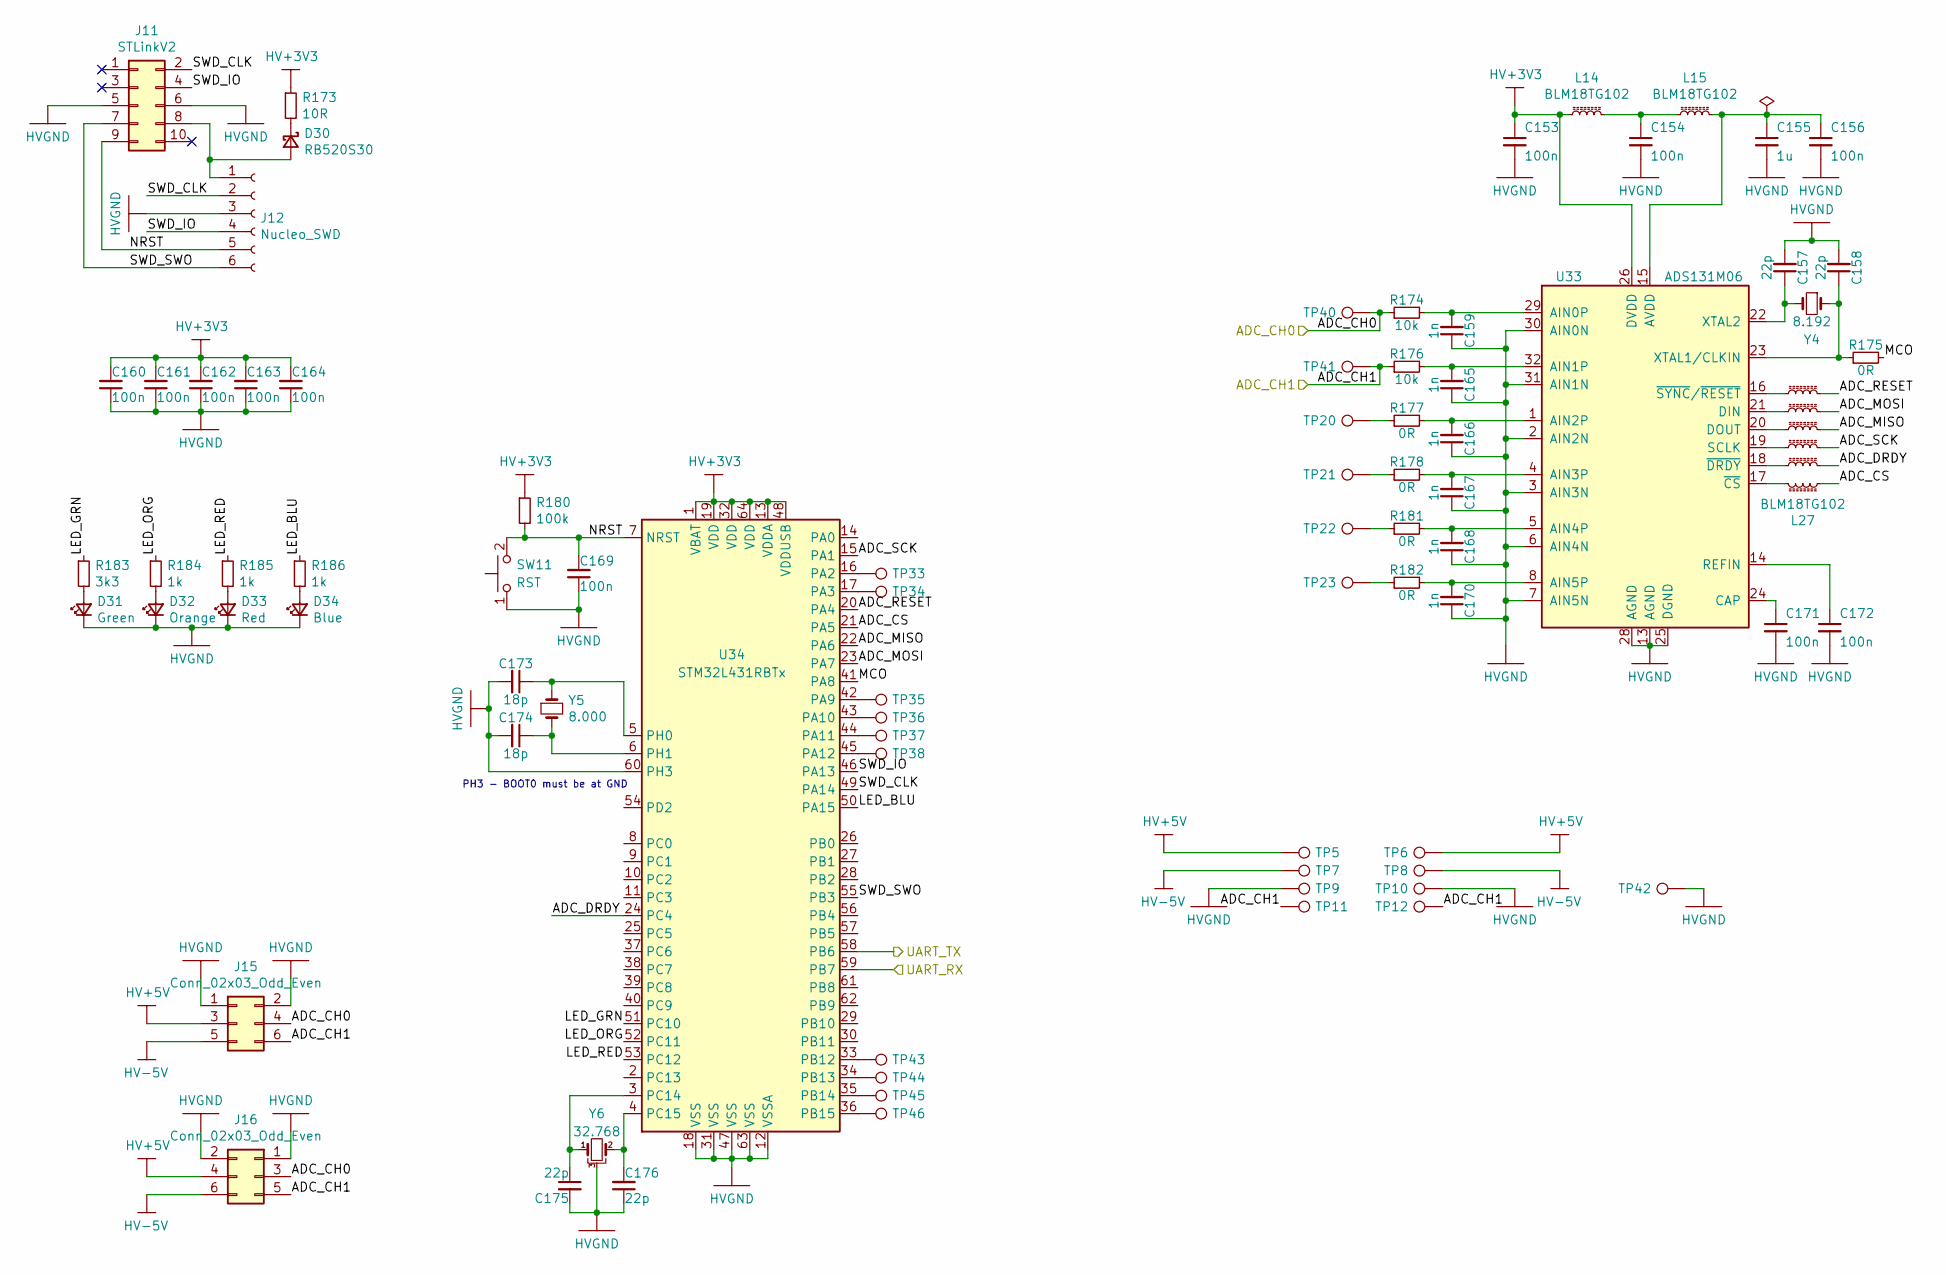
[picture p24: schematic MCU_high.sch, Procesor - katoda]

Parts:
C153, C154, C156, C160, C161, C162, C163, C164, C169, C171, C172: 100n; C_0603_1608Metric
C155: 1u; C_0603_1608Metric
C157, C158, C175, C176: 22p; C_0603_1608Metric
C159, C165, C166, C167, C168, C170: 1n; C_0603_1608Metric
C173, C174: 18p; C_0603_1608Metric
D30: RB520S30; D_SOD-323-523_HandSoldering
D31: Green; D_0805_2012Metric_Pad1.15x1.40mm_HandSolder
D32: Orange; D_0805_2012Metric_Pad1.15x1.40mm_HandSolder
D33: Red; D_0805_2012Metric_Pad1.15x1.40mm_HandSolder
D34: Blue; D_0805_2012Metric_Pad1.15x1.40mm_HandSolder
J11: STLinkV2; ST-LinkV2_FakeStm8Stm32_vertical
J12: Nucleo_SWD; PinSocket_1x06_P2.54mm_Vertical
J15, J16: Conn_02x03_Odd_Even; PinSocket_2x03_P2.54mm_Vertical
L14, L15, L22, L23, L24, L25, L26, L27: BLM18TG102; L_0603_1608Metric
R173: 10R; R_0603_1608Metric
R174, R176: 10k; R_0603_1608Metric
R175, R177, R178, R181, R182: 0R; R_0603_1608Metric
R180: 100k; R_0603_1608Metric
R183: 3k3; R_0603_1608Metric
R184, R185, R186: 1k; R_0603_1608Metric
SW11: RST; SW_Push_1P1T_NO_6x6mm_H9.5mm
TP5, TP6, TP7, TP8, TP9, TP10, TP11, TP12, TP20, TP21, TP22, TP23, TP33, TP34, TP35, TP36, TP37, TP38, TP40, TP41, TP42, TP43, TP44, TP45, TP46: TestPoint; TestPoint_THTPad_D1.5mm_Drill0.7mm
U33: ADS131M06; TQFP-32_5x5mm_P0.5mm_edges
U34: STM32L431RBTx; LQFP-64_10x10mm_P0.5mm
Y4: 8.192; Crystal_HC49-4H_Vertical
Y5: 8.000; Crystal_HC49-4H_Vertical
Y6: 32.768; Crystal_C38-LF_D3.0mm_L8.0mm_Horizontal_1EP_style1

Connections:
/ADC_UE: J15.4, J16.3, R174.1, TP40.1; also elsewhere on the board
/ADC_UF: J15.6, J16.5, R176.1, TP11.1, TP12.1, TP41.1; also elsewhere on the board
/HV_UART_RX: U34.59 (PB7); also elsewhere on the board
/HV_UART_TX: U34.58 (PB6); also elsewhere on the board
/MCU_high/ADC_CS: L27.1, U34.21 (PA5)
/MCU_high/ADC_DRDY: L26.2, U34.24 (PC4)
/MCU_high/ADC_MISO: L24.2, U34.22 (PA6)
/MCU_high/ADC_MOSI: L23.2, U34.23 (PA7)
/MCU_high/ADC_RESET: L22.2, U34.20 (PA4)
/MCU_high/ADC_SCK: L25.2, U34.15 (PA1)
/MCU_high/LED_BLU: R186.1, U34.50 (PA15)
/MCU_high/LED_GRN: R183.1, U34.51 (PC10)
/MCU_high/LED_ORG: R184.1, U34.52 (PC11)
/MCU_high/LED_RED: R185.1, U34.53 (PC12)
/MCU_high/MCO: R175.2, U34.41 (PA8)
/MCU_high/NRST: C169.2, J11.9, J12.5, R180.2, SW11.2, U34.7 (NRST)
/MCU_high/SWD_CLK: J11.2, J12.2, U34.49 (PA14)
/MCU_high/SWD_IO: J11.4, J12.4, U34.46 (PA13)
/MCU_high/SWD_SWO: J11.7, J12.6, U34.55 (PB3)
HV+3V3: C153.1, C160.2, C161.2, C162.2, C163.2, C164.2, L14.1, R173.1, R180.1, U33.26 (DVDD), U34.1 (VBAT), U34.13 (VDDA), U34.19 (VDD), U34.32 (VDD), U34.48 (VDDUSB), U34.64 (VDD); also elsewhere on the board
HV+5V: J15.3, J16.4, TP5.1, TP6.1; also elsewhere on the board
HV-5V: J15.5, J16.6, TP7.1, TP8.1; also elsewhere on the board
unnamed: C154.1, L14.2, L15.1
unnamed: C155.1, C156.1, L15.2, U33.15 (AVDD)
unnamed: C157.1, U33.22 (XTAL2), Y4.2
unnamed: C158.1, R175.1, U33.23 (XTAL1/CLKIN), Y4.1
unnamed: C159.2, R174.2, U33.29 (AIN0P)
unnamed: C165.2, R176.2, U33.32 (AIN1P)
unnamed: C166.2, R177.2, U33.1 (AIN2P)
unnamed: C167.2, R178.2, U33.4 (AIN3P)
unnamed: C168.2, R181.2, U33.5 (AIN4P)
unnamed: C170.2, R182.2, U33.8 (AIN5P)
unnamed: C171.1, U33.24 (CAP)
unnamed: C172.1, U33.14 (REFIN)
unnamed: C173.1, U34.5 (PH0), Y5.1
unnamed: C174.1, U34.6 (PH1), Y5.2
unnamed: C175.1, U34.3 (PC14), Y6.1
unnamed: C176.2, U34.4 (PC15), Y6.2
unnamed: D30.1 (K), R173.2
unnamed: D30.2 (A), J11.8, J12.1
unnamed: D31.2 (A), R183.2
unnamed: D32.2 (A), R184.2
unnamed: D33.2 (A), R185.2
unnamed: D34.2 (A), R186.2
unnamed: L22.1, U33.16 (~SYNC~/~RESET)
unnamed: L23.1, U33.21 (DIN)
unnamed: L24.1, U33.20 (DOUT)
unnamed: L25.1, U33.19 (SCLK)
unnamed: L26.1, U33.18 (~DRDY)
unnamed: L27.2, U33.17 (~CS)
unnamed: R177.1, TP20.1
unnamed: R178.1, TP21.1
unnamed: R181.1, TP22.1
unnamed: R182.1, TP23.1
unnamed: TP33.1, U34.16 (PA2)
unnamed: TP34.1, U34.17 (PA3)
unnamed: TP35.1, U34.42 (PA9)
unnamed: TP36.1, U34.43 (PA10)
unnamed: TP37.1, U34.44 (PA11)
unnamed: TP38.1, U34.45 (PA12)
unnamed: TP43.1, U34.33 (PB12)
unnamed: TP44.1, U34.34 (PB13)
unnamed: TP45.1, U34.35 (PB14)
unnamed: TP46.1, U34.36 (PB15)

Notes on the sheet:
PH3 - BOOT0 must be at GND

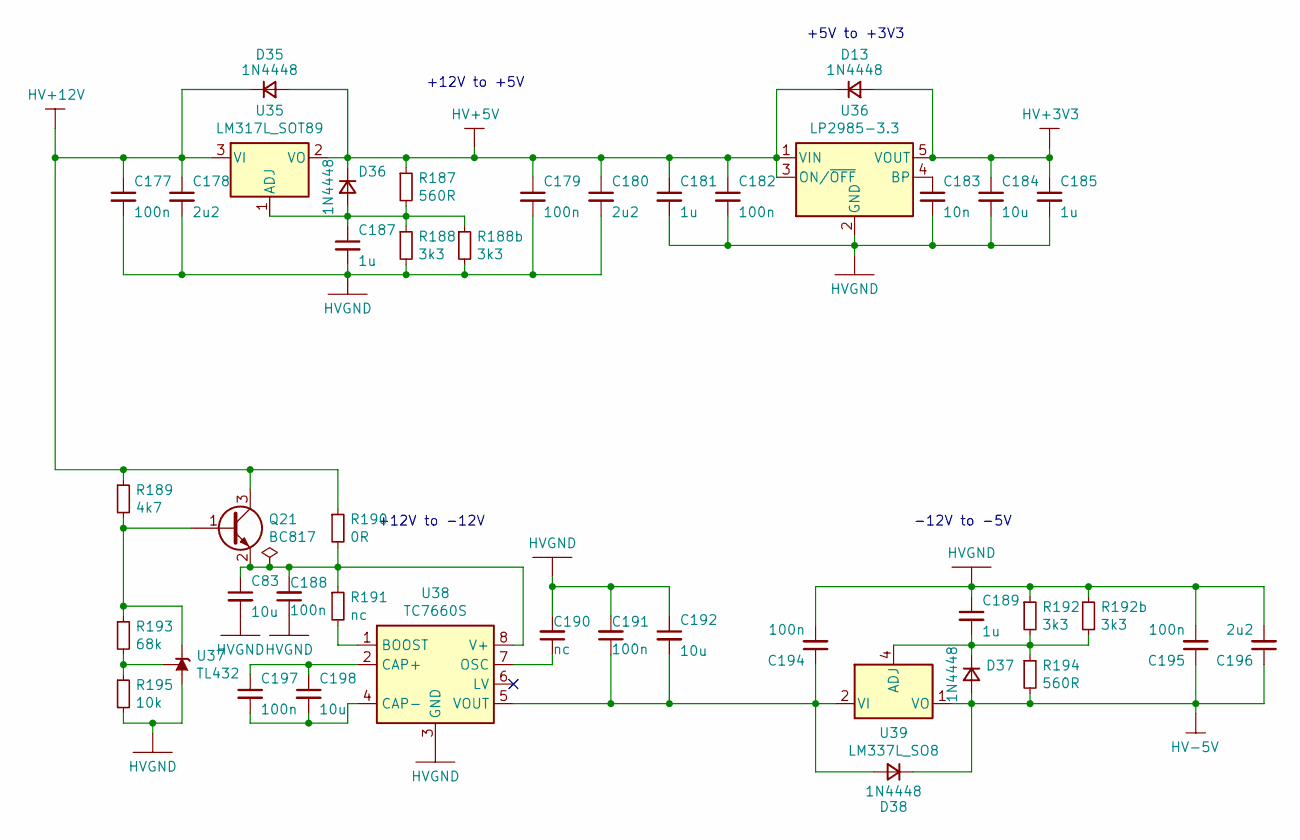
[picture p25: schematic supply_high.sch, Zasilanie - katoda]

Parts:
C83, C184, C192, C198: 10u; C_0603_1608Metric_Pad1.05x0.95mm_HandSolder
C177, C179, C182, C188, C191, C194, C195, C197: 100n; C_0603_1608Metric
C178, C180, C196: 2u2; C_0805_2012Metric
C181, C185, C187, C189: 1u; C_0603_1608Metric
C183: 10n; C_0603_1608Metric
C190: nc; C_0603_1608Metric
D13, D35, D36, D37, D38: 1N4448; D_SOD-323-523_HandSoldering
Q21: BC817; SOT-23
R187, R194: 560R; R_0603_1608Metric_Pad1.05x0.95mm_HandSolder
R188, R188b, R192: 3k3; R_0603_1608Metric_Pad1.05x0.95mm_HandSolder
R189: 4k7; R_0603_1608Metric
R190: 0R; R_0603_1608Metric
R191: nc; R_0603_1608Metric
R192b: 3k3
R193: 68k; R_0603_1608Metric_Pad1.05x0.95mm_HandSolder
R195: 10k; R_0603_1608Metric_Pad1.05x0.95mm_HandSolder
U35: LM317L_SOT89; SOT-89-3
U36: LP2985-3.3; SOT-23-5
U37: TL432; SOT-23
U38: TC7660S; SOIC-8_3.9x4.9mm_P1.27mm
U39: LM337L_SO8; SOIC-8_3.9x4.9mm_P1.27mm

Connections:
HV+3V3: C184.1, C185.1, D13.2 (A), U36.5 (VOUT); also elsewhere on the board
HV+5V: C179.1, C180.1, C181.1, C182.1, D13.1 (K), D35.2 (A), D36.1 (K), R187.1, U35.2 (VO), U36.1 (VIN), U36.3 (ON/~OFF~); also elsewhere on the board
HV+12V: C177.1, C178.1, D35.1 (K), Q21.3 (C), R189.1, R190.1, U35.3 (VI); also elsewhere on the board
HV-5V: C195.1, C196.1, D37.2 (A), D38.1 (K), R194.2, U39.1 (VO); also elsewhere on the board
unnamed: C183.1, U36.4 (BP)
unnamed: C187.1, D36.2 (A), R187.2, R188.1, R188b.1, U35.1 (ADJ)
unnamed: C83.1, C188.2, Q21.2 (E), R190.2, R191.1, U38.8 (V+)
unnamed: C189.2, D37.1 (K), R192.2, R192b.2, R194.1, U39.4 (ADJ)
unnamed: C190.1, U38.7 (OSC)
unnamed: C191.1, C192.2, C194.1, D38.2 (A), U38.5 (VOUT), U39.2 (VI), U39.3 (VI), U39.6 (VI), U39.7 (VI)
unnamed: C197.1, C198.1, U38.2 (CAP+)
unnamed: C197.2, C198.2, U38.4 (CAP-)
unnamed: Q21.1 (B), R189.2, R193.1, U37.2 (K)
unnamed: R191.2, U38.1 (BOOST)
unnamed: R193.2, R195.1, U37.1 (REF)

Notes on the sheet:
+12V to -12V
-12V to -5V
+12V to +5V
+5V to +3V3

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
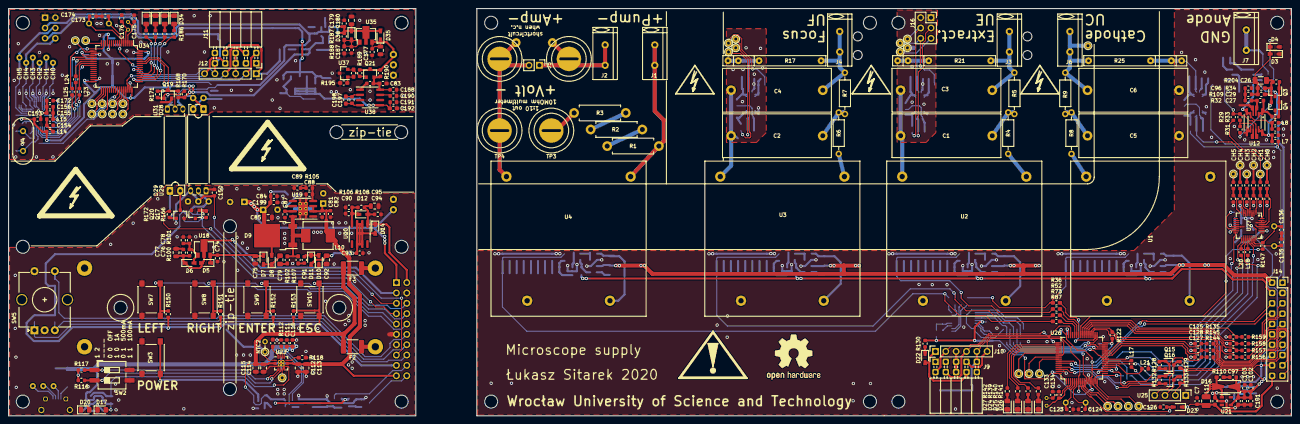
[picture p26: board uScope.kicad_pcb from above]

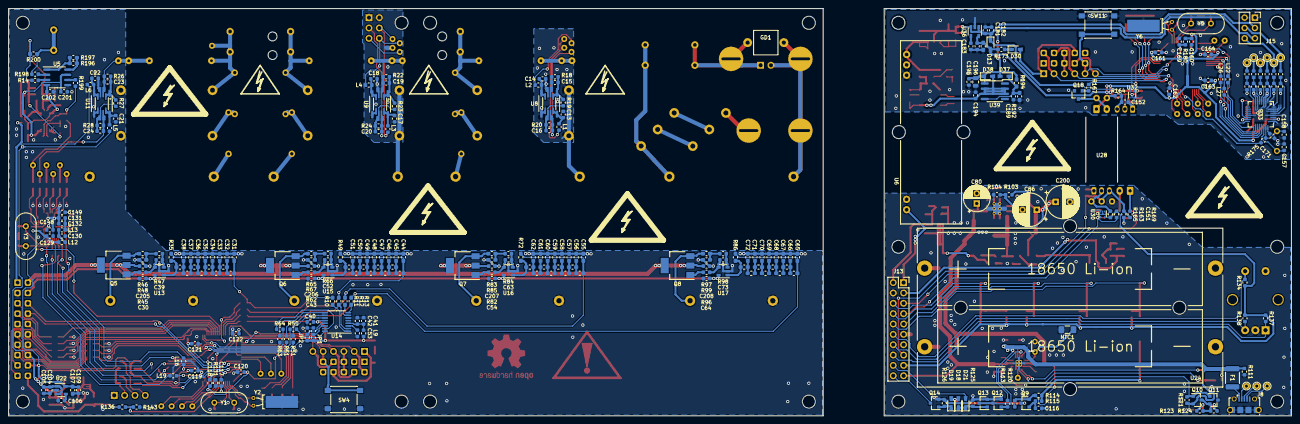
[picture p27: board uScope.kicad_pcb from below]

Board: 2 copper layers, 315.0 x 100.0 mm, 591 parts (293 on the bottom side), 336 nets.
