PCB-schema/uScope/(commit log)

2020-08-22 - More schematics, - gitignore
    [uScope_koncepcja.sch, uScope_koncepcja1.sch, uScope_koncepcja2.sch, uScope_koncepcja3.sch]
2020-08-22 - schematic as hierarchical - added cache lib
    [uScope.sch, uScope_koncepcja.sch, uScope_koncepcja1.sch, uScope_koncepcja2.sch, uScope_koncepcja3.sch]
2020-08-22 - moved voltmeters to separate sheet - hierarchical sheets
    [postRegulator.sch, uScope.sch, uScope_koncepcja.sch, uScope_koncepcja1.sch, uScope_koncepcja2.sch, uScope_koncepcja3.sch, voltmeters.sch]
2020-09-15 - added DC/DC converter to library, - moved ammeter & drivers to sub-sheet, - further develop
    [ammeter.sch, drivers.sch, postRegulator.sch, uScope.sch, uScope_koncepcja.sch, uScope_koncepcja1.sch, uScope_koncepcja2.sch, uScope_koncepcja3.sch]
2020-09-16 - added supply sch draft
    [ammeter.sch, drivers.sch, postRegulator.sch, supply.sch, uScope.sch, uScope_koncepcja.sch, uScope_koncepcja1.sch, uScope_koncepcja2.sch]
2020-09-21 - battery charger develop - added sheet (every sheet contains total number of sheets, thats beacouse here are changes in all sheets)
    [Battery_Charger.sch, ammeter.sch, drivers.sch, postRegulator.sch, supply.sch, uScope.sch, uScope_koncepcja.sch, uScope_koncepcja1.sch]
2020-09-21 - supply converter develop - added sheet: MCU - cleanup 'koncepcja' sub-schematics
    [Battery_Charger.sch, ammeter.sch, drivers.sch, postRegulator.sch, supply.sch, uScope.sch, uScope_koncepcja.sch, uScope_koncepcja1.sch]
2020-09-21 - added sheet: MCU
    [MCU.sch]
2020-09-23 - added footprint & 3D model of DC/DC HV converter - updated battery (to 2x battery holder) - some changes in supply
    [Battery_Charger.sch, drivers.sch, supply.sch, uScope.sch, voltmeters.sch]
2020-10-09 - changes..
    [Battery_Charger.sch, MCU.sch, ammeter.sch, drivers.sch, postRegulator.sch, supply.sch, uScope.sch, uScope_koncepcja.sch]
2020-10-13 - W.i.P.
    [Battery_Charger.sch, MCU.sch, MCU_high.sch, MCU_low.sch, ammeter.sch, communication.sch, drivers.sch, postRegulator.sch]
2020-10-14 - MCU_Low: added encoder, DAC, alternate MCU
    [MCU_low.sch, uScope.sch, uScope_koncepcja.sch]
2020-10-22 - drivers modified - MCU replaced
    [MCU_high.sch, MCU_low.sch, drivers.sch, postRegulator.sch, supply.sch, uScope.sch, voltmeters.sch]
2020-10-23 - connect things to MCUlow (DAC, screen, keys, debug) - improvement in charger (read PWR key)
    [Battery_Charger.sch, MCU_low.sch, ammeter.sch, drivers.sch, supply.sch, uScope.sch]
2020-11-02 - high side (supply, MCU) - low side MCU - much small changes
    [Battery_Charger.sch, MCU_high.sch, MCU_low.sch, ammeter.sch, communication.sch, drivers.sch, postRegulator.sch, supply.sch]
2020-11-02 - final schematic
    [Battery_Charger.sch, MCU_high.sch, MCU_low.sch, ammeter.sch, communication.sch, drivers.sch, rippleMeas.sch, supply.sch]
2020-11-03 - init PCB - fix last things in schematic
    [Battery_Charger.sch, MCU_high.sch, MCU_low.sch, ammeter.sch, drivers.sch, rippleMeas.sch, supply.sch, supply_high.sch]
2020-11-03 - first segregation on pcb
    [drivers.sch, uScope.kicad_pcb]
2020-11-05 - pcb placement, add 3dShapes
    [MCU_high.sch, MCU_low.sch, uScope.kicad_pcb, uScope.sch]
2020-11-09 - PCB progress
    [Battery_Charger.sch, MCU_high.sch, MCU_low.sch, ammeter.sch, communication.sch, drivers.sch, rippleMeas.sch, supply.sch]
2020-11-11 - PCB WiP - Pump output aligned
    [Battery_Charger.sch, MCU_high.sch, MCU_low.sch, ammeter.sch, communication.sch, drivers.sch, supply.sch, supply_high.sch]
2020-11-13 - PCB WiP
    [Battery_Charger.sch, MCU_low.sch, ammeter.sch, uScope.kicad_pcb, uScope.sch]
2020-11-19 - PCB WiP - polygons on PCB small
    [uScope.kicad_pcb]
2020-11-25 - PCB final !!!!! before DRC
    [uScope.kicad_pcb]
2020-11-25 - PCB final before split
    [uScope.kicad_pcb]
2021-03-14 - as-built changes - add custom library elements
    [Battery_Charger.sch, MCU_high.sch, MCU_low.sch, ammeter.sch, communication.sch, drivers.sch, supply.sch, supply_high.sch]
2021-03-14 - update schematic pdf print
